droggen/BlueSense4/img/bot.png

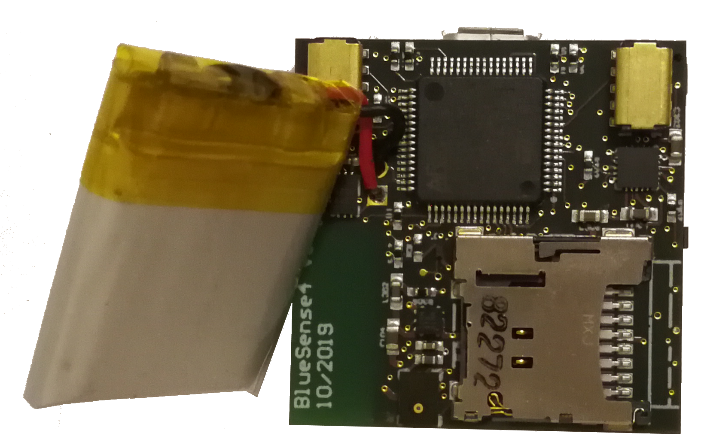
img/bot.png
