droggen/BlueSense4/img/side.png

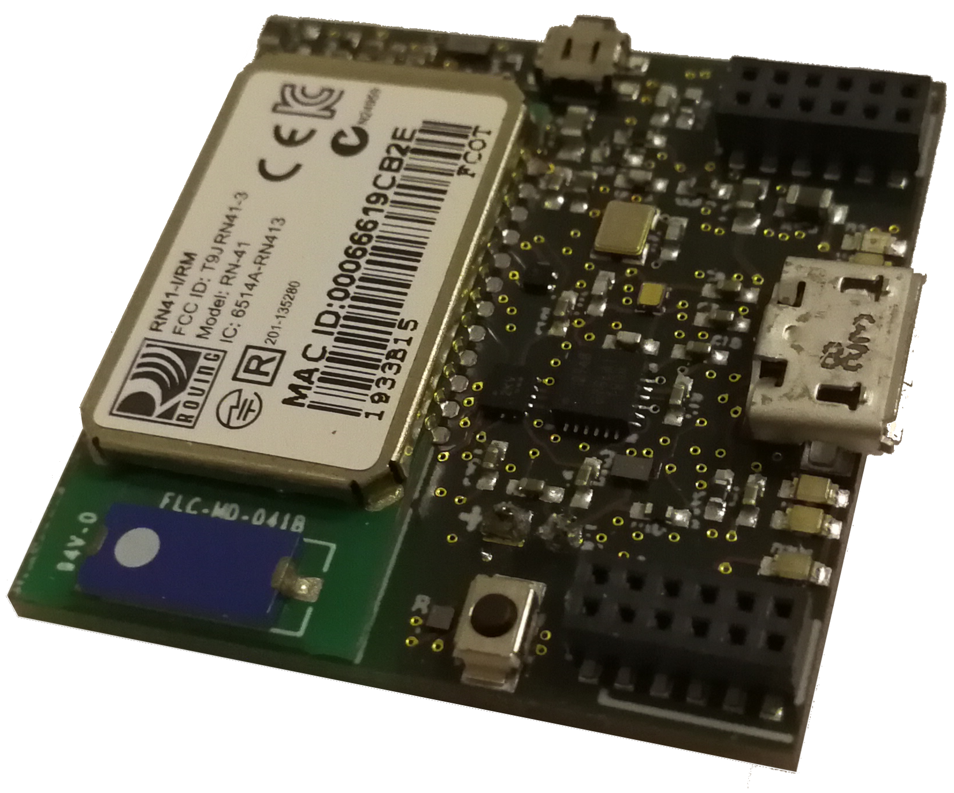
img/side.png
