droggen/BlueSense4/img/top.png

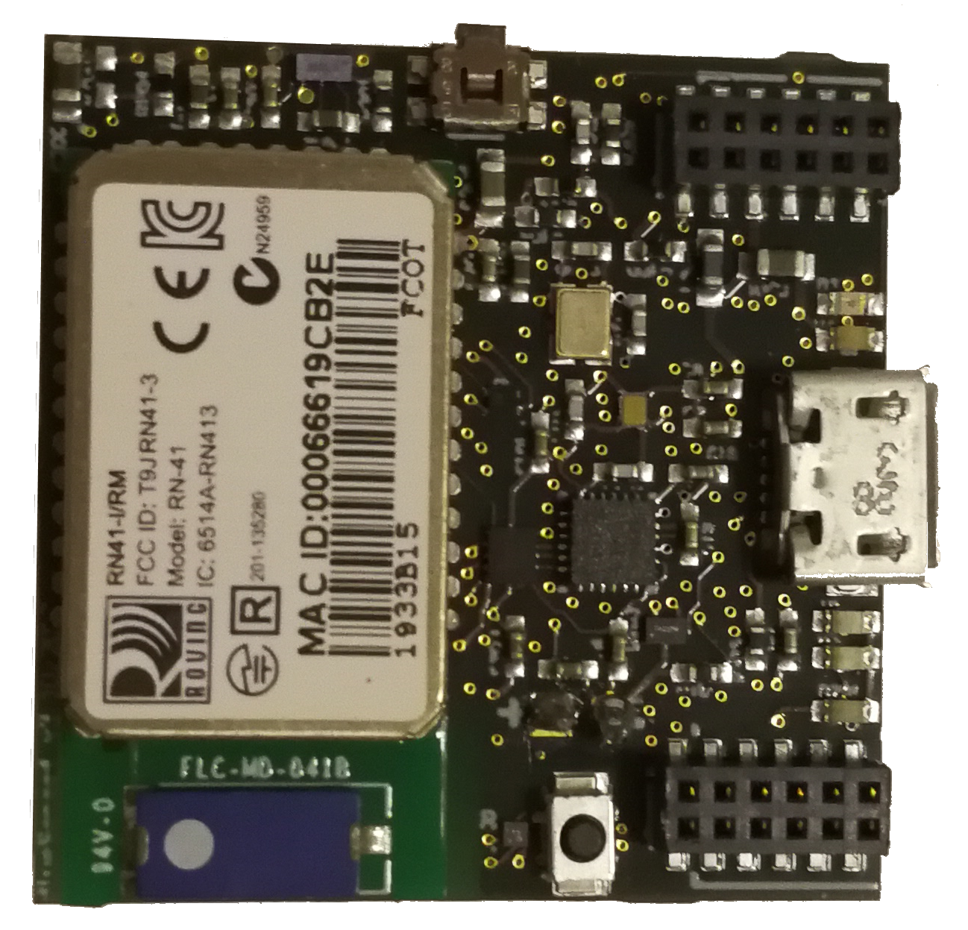
img/top.png
