droggen/BlueSense4/hardware/v4/bluesense4_v4.xls

Sheet: BOM Report
BOM Beta LAYOUT GmbH
 |  |  | <Parameter Title not found>
Source Data From: |  | bluesense4.PrjPcb
Project: |  | bluesense4.PrjPcb
Variant: |  | None
Creation Date: | 10.06.2020 |  |  | Total components (including those not to populate): |  |  |  | 92
Print Date: | 2020-06-10 | 16:18:03 |  | Total components to assemble: |  |  |  | 88
 |  |  |  | Total unique components (BoM lines): |  |  |  | 44
Production Quantity: | 1
Designator | Comment | LibRef | Footprint | Description | Quantity | Place YES / NO | Provided by Customer YES / NO | Distributor | Ordernumber | Remarks Customer | Remarks Beta
BT1 | Battery 3.7V Li-Ion | Battery | BAT-3LL | Multicell Battery | 1 | NO |  | Farnell | 2077885
C2, C5, C6, C8, C15, C16, C19, C101, C106, C202, C203, C204, C205, C207, C302, C307 | 100nF | Cap | 1005[0402] | CPU decoupling, CPU decoupling, CPU decoupling, CPU VDDA decoupling, Motion analog decoupling, Motion digital decoupling, Motion regout decoupling, CPU decoupling, uSD decoupling, Mic decoupling, Motion analog decoupling, BLE decoupling, RTC decoupling, Mic decoupling, CPU VDDA decoupling, Multivibrator decoupling | 16 | YES | NO | Farnell | 9402047
C3, C200, C201, C206, C308 | 4.7uF | Cap | 1005[0402] | SD decoupling, Bluetooth decoupling, Mic decoupling, Mic decoupling, Multivibrator time constant | 5 | YES | NO | Farnell | 2346876
C100, C102 | 13pF (id. 14pF) | Cap | 1005[0402] | CPU main clock | 2 | YES | NO | Farnell | 1758944
C104, C300, C301 | 22uF | Cap | 1608[0603] | uSD decoupling, VCC decoupling, AVCC decoupling | 3 | YES | NO | Digikey | 445-9077-1-ND
C105, C107 | 2pF | Cap | 1005[0402] | CPU RTC clock | 2 | YES | NO | Farnell | 2781430
C303, C304, C306 | 10uF | Cap | 1608[0603] | VBUS decoupling, Vreg vout decoupling, Vreg buck decoupling | 3 | YES | NO | Farnell | 2309028
C305 | 12pF | Cap | 1005[0402] | Vreg buck | 1 | YES | NO | Farnell | 1758943
D1 | Red | LED_SMD | LED_ROHM0603 | Status LED | 1 | YES | NO | Farnell | 1685094
D3, D200 | Yellow | LED_SMD | LED_ROHM0603 | Status LED | 2 | YES | NO | Farnell | 2687489
D201 | Green | LED_SMD | LED_ROHM0603 | Status LED2 | 1 | YES | NO | Farnell | 2687486
D300 | Blue | LED_SMD | LED_ROHM0603 | Charging LED | 1 | YES | NO | Farnell | 1685096
J1 | Molex MICRO USB B | MicroUSB-HRS-ZX62-AB-5PA | MICROUSB-MOLEX-47346 | Molex MICRO USB B - 47346-0001 | 1 | YES | NO | Digikey | WM17141CT-ND
J300 | Pad | PAD1 | TP2 |  | 1 | NO
L300, L301, L302 | 4.7uH | Inductor | 1608[0603] | Buck, AVCC filter, Periph filter | 3 | YES | NO | Farnell | 2215636
P2, P5 | Header 12H | Header 12H | Samtec CLP-106 | Header, 12-Pin, Right Angle | 2 | YES | NO | Samtec | CLP-106-02-L-D-P
P300, P301 | Samtec CLP-105-02-L-D | Header 10H | Samtec CLP-105b | Expansion bot, Expansion bottom | 2 | YES | NO | Samtec | CLP-105-02-L-D-P
Q300 | MOSFET-N | MOSFET-N | SOT883 | N-Channel MOSFET | 1 | YES | NO | Farnell | 2498592
R100, R200 | 0R | Res Semi | 1005[0402] | STM bootloader bridge, Bluetooth factory reset pad | 2 | NO |  | Farnell | 2059190
R313, R314 | 0R | Res Semi | 1005[0402] | RTC_INT bridge, PWR_ON bridge | 2 | YES | NO | Farnell | 2059190
R102, R204, R311 | 47k | Res Semi | 1005[0402] | Boot1 pullup, Bluetooth factory reset pad, Boot1 pullup | 3 | YES | NO | Farnell | 1469719
R201, R202, R312, RD1, RD3, RD200, RD201, RD300 | 4k7 | Res Semi | 1005[0402] | I2C pullup, I2C pullup, PWR_ON pull down, LED, LED, LED, LED, LED | 8 | YES | NO | Farnell | 1738858
R300, R309 | 0R22 | Res Semi | 1005[0402] | AVCC filter, Periph filter | 2 | YES | NO | Farnell | 1838595
R301, R304 | 536k | Res Semi | 1005[0402] | Multivibrator time constant, LDO sense | 2 | YES | NO | Farnell | 2302922
R302, R305 | 1M5 | Res Semi | 1005[0402] | LDO sense, Buck sense | 2 | YES | NO | Farnell | 2447129
R303 | 820 | Res Semi | 1005[0402] | VUSB divider | 1 | YES | NO | Farnell | 2447218
R306 | 470k | Res Semi | 1005[0402] | Buck sense | 1 | YES | NO | Farnell | 2141002
R307 | 7k5 | Res Semi | 1005[0402] | Charge current | 1 | YES | NO | Farnell | 2073238
R308 | 100R | Res Semi | 1005[0402] | Bleed resistor | 1 | YES | NO | Farnell | 2302528
R310 | 1.2k | Res Semi | 1005[0402] | VUSB divider | 1 | YES | NO | Farnell | 2447122
S4 | B3U-3000P | SW-PB | EVQP7A/J | Switch | 1 | YES | NO | Digikey | P16763CT-ND
U3 | ICM-20948 | MPU9250 | QFN40P300X300X105_HS-25L | Invensense ICM-20948 (ex MPU9250) | 1 | YES | NO | Digikey | 1428-1123-1-ND
U8 | LTC3553 | LTC3553 | LTC3553 | Linear LTC3553 | 1 | YES | NO | Digikey | LTC3553EUD#PBF-ND
U101 | RN41-I/RM | RN41 | rn41 | RN41 | 1 | YES | NO | Digikey | 740-1007-ND
U102 | STM32L496RET | STM32L496RET | STM-LQFP64_V | ARM Cortex-M4 32-bit MCU+FPU, 105 DMIPS, 256 kB Flash, 64 kB Internal RAM, 48 I/Os, 64-pin LQFP, -40 to 85 degC, Tray | 1 | YES | NO | Digikey | 497-17172-ND
U103 | Molex uSD socket #503182 | Molex uSD socket #503182 | Molex uSD Socket #503182 (v2) |  | 1 | YES | NO | Mouser | 538-503182-1852
U200 | M24xxx | M24xxx | UltraThinWLCSP | I2C EEPROM (M24128S-FCUT) | 1 | YES | NO | Farnell | 2449210
U201, U201b | MP34DT05 | MP34DT05 | MP34DT06 |  | 2 | YES | NO | Farnell | 2980885
U202 | TXB0104_1 | TXB0104_1 | R-PUQFN-N12 | 4-Bit Bidirectional Voltage-level Translator With Automatic Direction Sensing | 1 | YES | NO | Digikey | 296-25888-1-ND
U203 | TXB0101 | TXB0101 | DSBGA6 | 1-Bit Bidirectional Voltage-level Translator With Automatic Direction Sensing | 1 | YES | NO | Digikey | 296-21927-1-ND
U204 | MAX31343 RTC | DS31343 | 8-WLP | MAX31343 RTC | 1 | YES | NO | Digikey | 175-MAX31343EKA+-ND
U300 | LTC2942 | LTC2942 | DFN-6 | Coulomb counter | 1 | YES | NO | Digikey | LTC2942CDCB-1#TRMPBFCT-ND
U301 | TPS22810 | TPS22810-WSON | TPS22810-WSON | 79-mΩ On-Resistance Load Switch With Thermal Protection | 1 | YES | NO | Digikey | 296-47868-1-ND
U302 | SN74LVC1G123YZP | SN74LVC1G123 |  | Multivibrator | 1 | YES | NO | Digikey | 296-21058-1-ND
U303 | TLV713 | TLV713 | TI-DQN4-480X480TP_V_dan |  | 1 | YES | NO | Digikey | 296-40652-1-ND
Y100 | Quartz4pin | Quartz4pin | Abracon Crystal 2.0x1.6mm | ABM11-16.000MHZ-12-N1G-T | 1 | YES | NO | Farnell | 3228464
Y101 | Quartz4pin | Quartz4pin | ABRACON CRYSTAL 1.2x1 | ABS04W-32.768KHZ-6-D2-T5 (6pF) | 1 | YES | NO | Digikey | 535-14814-1-ND

Sheet: Project Information
Project Full Path | Free Documents
Project Filename | Free Documents
Variant Name | None
Data-Source Filename | BS50602e3f4ab07_UniAdc_pcbpool_20120924115706.PcbDoc
Data-Source Full Path | U:\Job\BA\Altium Testfile\BS50602e3f4ab07_UniAdc_pcbpool_20120924115706.PcbDoc
Title | Bill of Materials For PCB Document [BS50602e3f4ab07_UniAdc_pcbpool_20120924115706.PcbDoc]
Total Quantity | 55
Report Time | 10:07:24
Report Date | 16.10.2012
Report Date & Tine | 16.10.2012 10:07:24
Output Name | Bill of Materials
Output Type | BOM_PartType
Output Generator Name | ReportComponents
Output Generator Description | Component Reports
