droggen/BlueSense4/hardware/v4/bluesense_v4_schematic.pdf

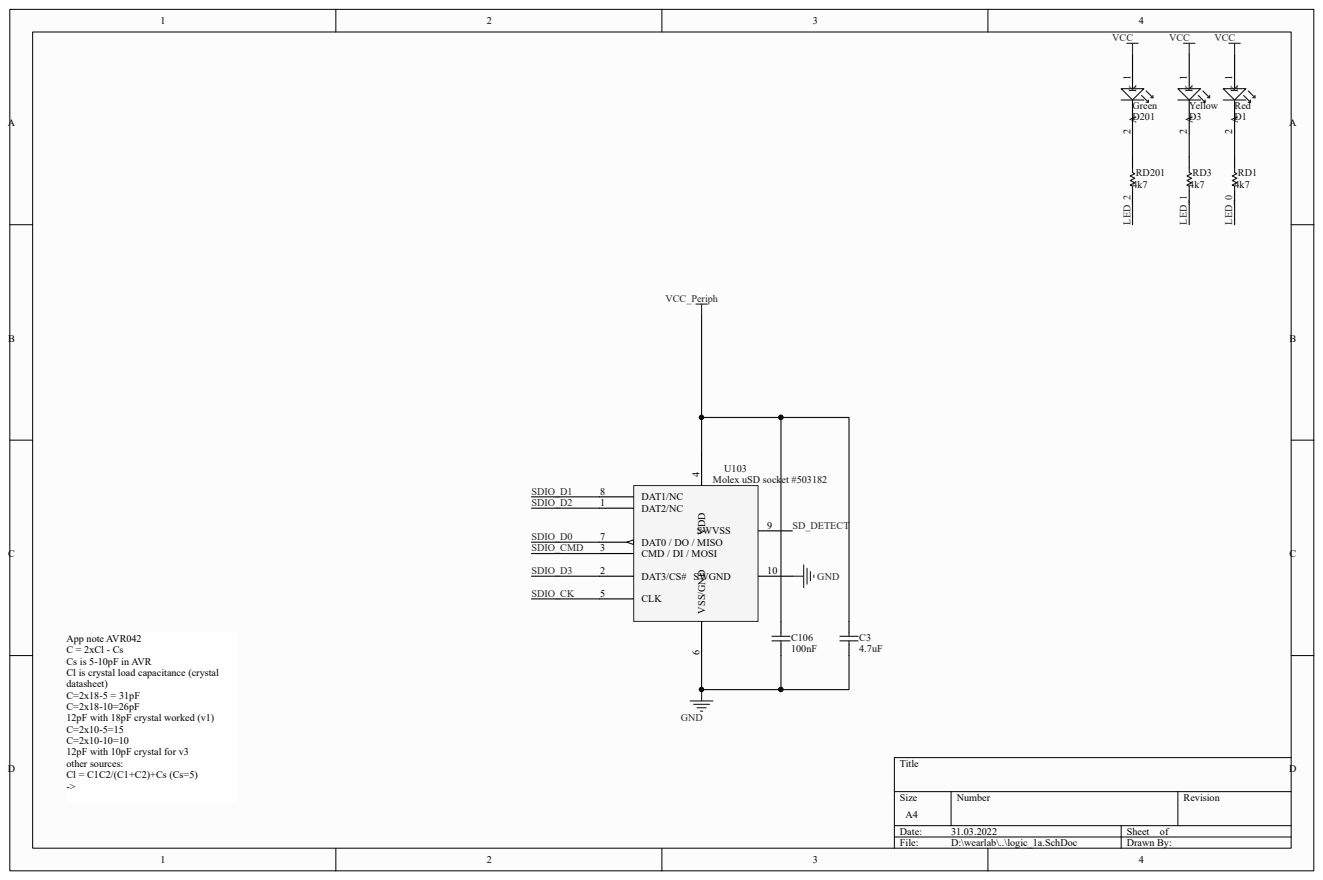
[picture p5: page 1]
Title; Size; Number; Revision; Date:; Sheet of; File:; D:\wearlab\..\logic_1a.SchDoc; Drawn By:; VCC_Periph; GND; VCC; Yellow; Red; DAT0 / DO / MISO 7; DAT2/NC 1; DAT3/CS# 2; CMD / DI / MOSI 3; VDD; CLK 5; VSS/GND; DAT1/NC 8; SWVSS; SWGND; LED_2; Green; SDIO_D0; SDIO_D1 SDIO_D2; SDIO_D3; SDIO_CK; SDIO_CMD; LED_1; LED_0; SD_DETECT

Molex uSD socket #503182

App note AVR042
C = 2xCl - Cs
Cs is 5-10pF in AVR
Cl is crystal load capacitance (crystal
datasheet)
12pF with 18pF crystal worked (v1)
12pF with 10pF crystal for v3
other sources:

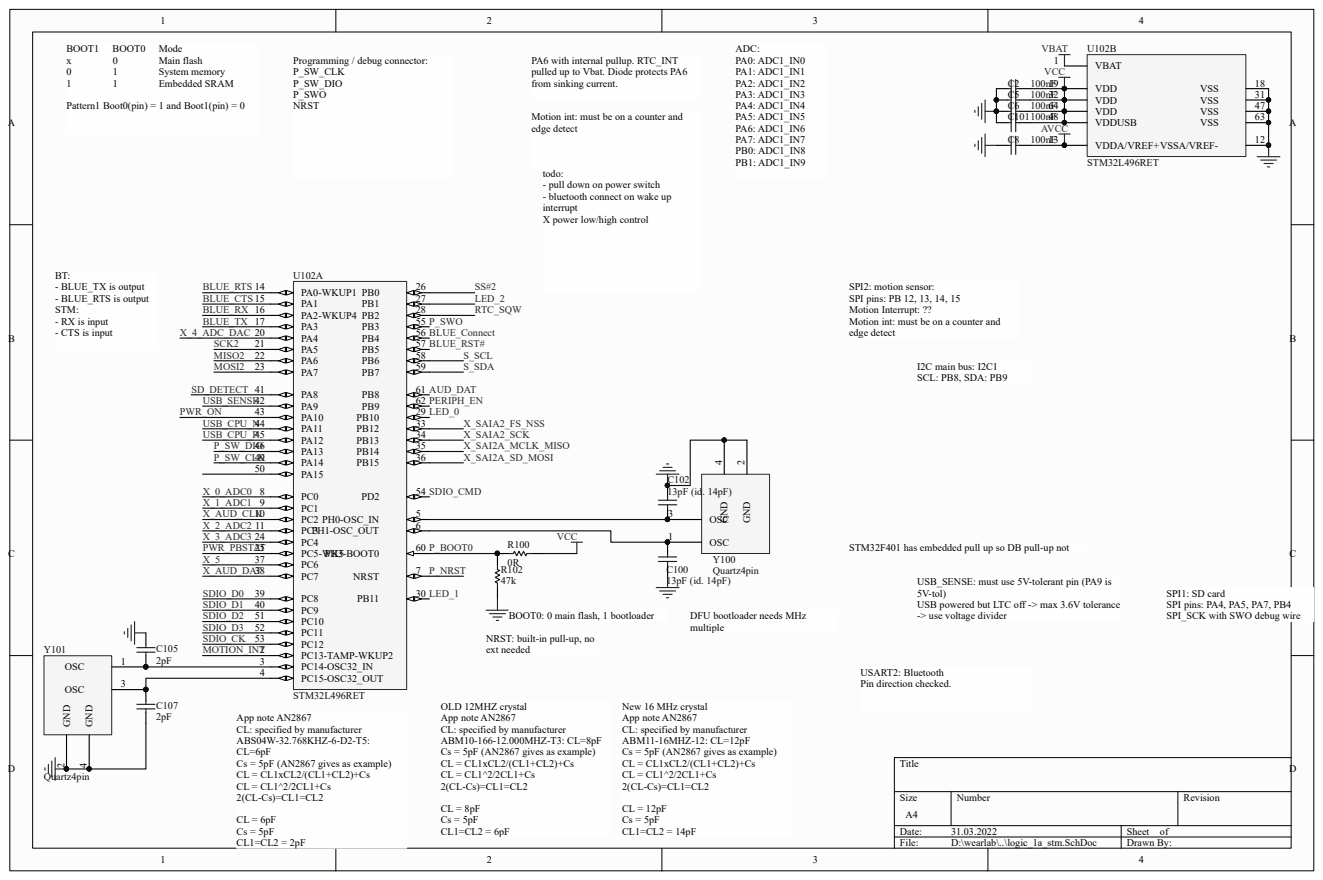
[picture p6: page 2]

PA6 with internal pullup. RTC_INT
pulled up to Vbat. Diode protects PA6
from sinking current.

Motion int: must be on a counter and
edge detect

todo:
- pull down on power switch
- bluetooth connect on wake up
interrupt
X power low/high control

SPI2: motion sensor:
SPI pins: PB 12, 13, 14, 15
Motion Interrupt: ??

STM32F401 has embedded pull up so DB pull-up not

USB_SENSE: must use 5V-tolerant pin (PA9 is
5V-tol)
USB powered but LTC off -> max 3.6V tolerance
-> use voltage divider

SPI1: SD card
SPI pins: PA4, PA5, PA7, PB4
SPI_SCK with SWO debug wire

DFU bootloader needs MHz
multiple

NRST: built-in pull-up, no
ext needed

OLD 12MHZ crystal
App note AN2867
CL: specified by manufacturer
ABM10-166-12.000MHZ-T3: CL=8pF
Cs = 5pF (AN2867 gives as example)
CL = CL1xCL2/(CL1+CL2)+Cs

New 16 MHz crystal
ABM11-16MHZ-12: CL=12pF

ABS04W-32.768KHZ-6-D2-T5:

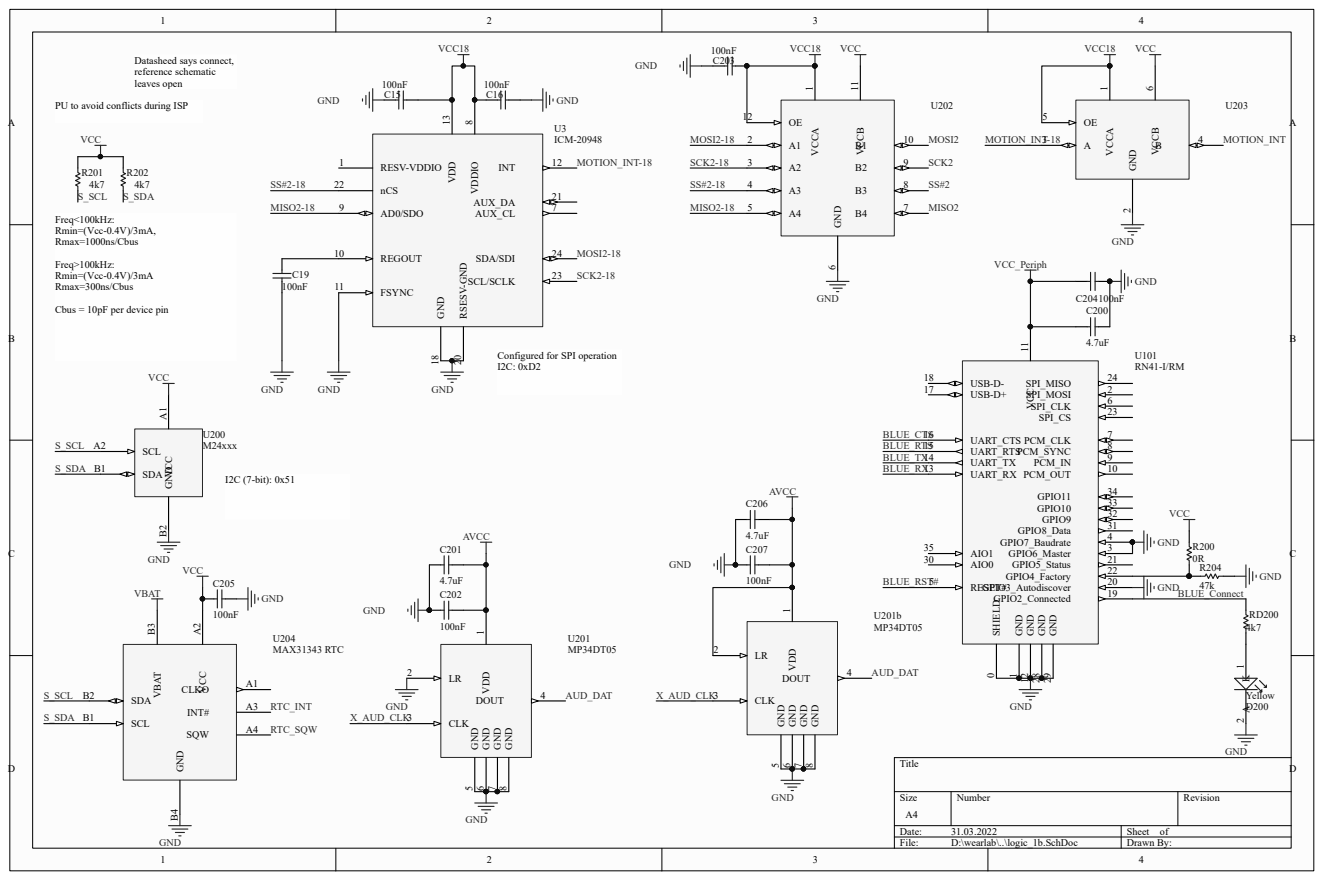
[picture p7: page 3]

PU to avoid conflicts during ISP

Cbus = 10pF per device pin

4.7uF VDD
Configured for SPI operation

1 GND 12 GND 29 GND 28 VCC 11

I2C (7-bit): 0x51 GND B² VCC A¹

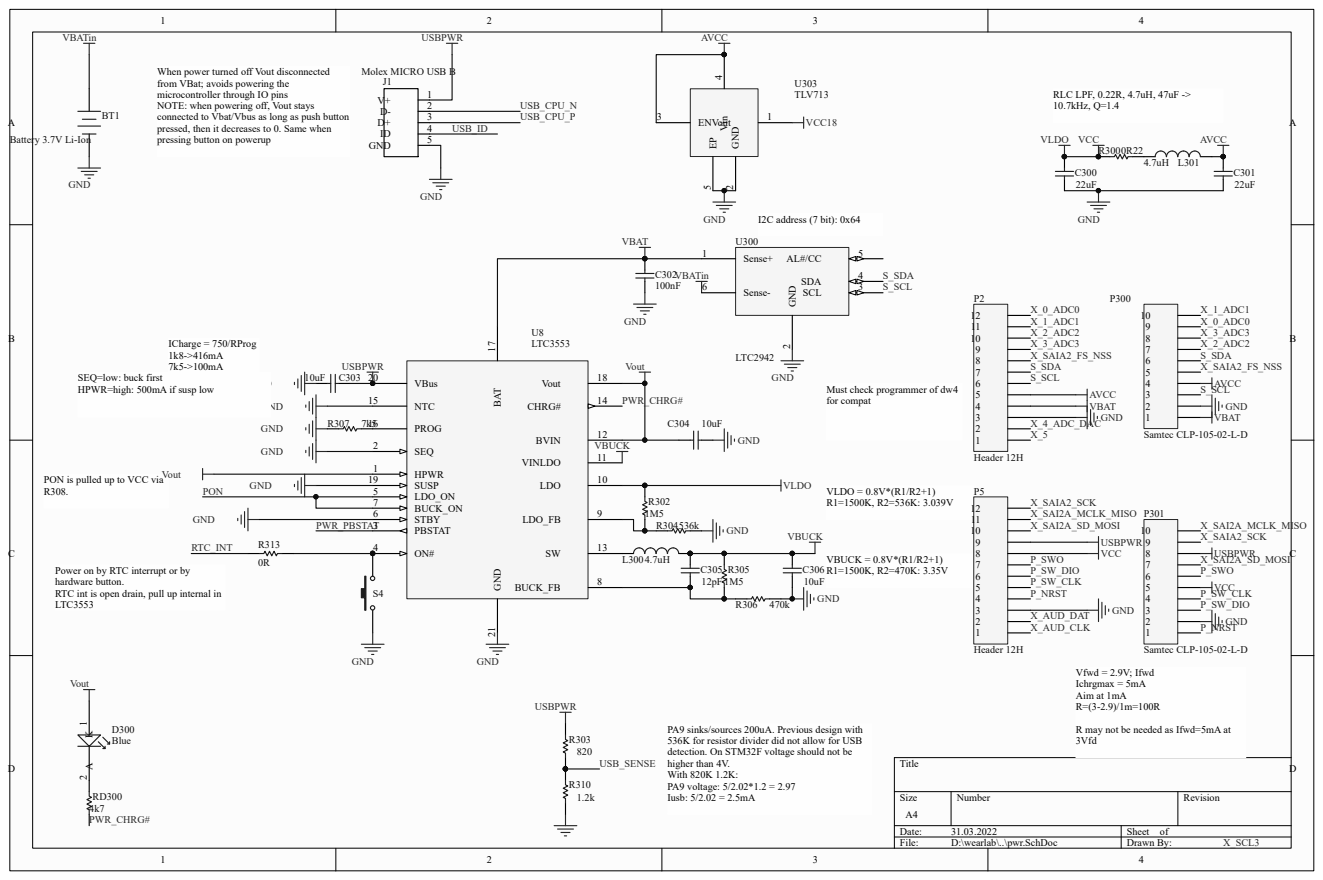
[picture p8: page 4]

When power turned off Vout disconnected
from VBat; avoids powering the
microcontroller through IO pins
NOTE: when powering off, Vout stays
connected to Vbat/Vbus as long as push button
pressed, then it decreases to 0. Same when
pressing button on powerup

SEQ=low: buck first
HPWR=high: 500mA if susp low

Must check programmer of dw4
for compat

PON is pulled up to VCC via

Power on by RTC interrupt or by
hardware button.
RTC int is open drain, pull up internal in
LTC3553

PA9 sinks/sources 200uA. Previous design with
536K for resistor divider did not allow for USB
detection. On STM32F voltage should not be
higher than 4V.
With 820K 1.2K:
PA9 voltage: 5/2.02*1.2 = 2.97
Iusb: 5/2.02 = 2.5mA

R may not be needed as Ifwd=5mA at
3Vfd

C C

B B

A A

== Power circuit ==
There are 4 cases:
A. Power is off, pwron through extpwr or PB
B. Power is off, pwron through RTC interrupt
C. Power is on, pwroff through CPU (pull up/down pwron)
D. Power is on, pwroff through hrst (long-press pb)

ON semi NSR05F40NXT5G has
Vf=0.1V 75C
Vf=0.2V 25C
Vf=0.3V -25C

Input voltage range: 3.4-4.3 Output voltage range: 2.5-4.0V

Has to operate with Vbat: 3.4V-4.3V

Put NMOS transistor to discharge NXP PMZ200UNE

== Falling edge detector on PWR_ON==
This generates a positive puse on the falling edge of PWR_ON (CPU controlled) or when VCC drops (e.g. through HRST). PWR_ON is a uC digital out and is pulled up to keep the supply active when the CPU is unprogrammed, in reset, or undergoing programming. Consequently, if VCC falls due to other reasons (e.g. due to a long-press/HRST on the LTC3553) a pulse is also generated as either VCC drops or PWR_ON drops (generally both drop at the same time as the uC is VCC powered).
Tpulse = C*R*K with K=1
Tpulse = R*C
C=2.2uF, R=450K -> 1s
* C=4.7uF, R=536 -> 2.5s GND

## 4 VCC

8

A# 1

B

2

CLR# 3 | Q

5

Ce | 6
Re/Ce | 7

U302
SN74LVC1G123YZP

GND

VBAT

VBAT

C308
4.7uF

R301
536k

PoffPulse

C307

100nF

GND

PoffPulse high indicates the
power must be cut off. | D
| 1

G

### 2 S

3

Q300
MOSFET-N

== Bleeder circuit ==
P=U2/R=90mW

GND

R308
100R

VCC 1

1

J300

Power switch TPS22810

== Power circuit ==
A. Power is off, pwron through extpwr or PB
- LTC turns on for 5 seconds; PON pulled high via R308.
- If cpu unprogrammed/being programmed: PWR_ON HiZ; A# is VCC and no poffpulse.
- If cpu programmed: actively drives PWR_ON low.

PON

PWR_ON

R312
4k7

== Power circuit ==
B. Power is off, pwron through RTC interrupt
Same as A: rtc interrupt is equivalent to button press.

== Power circuit ==
C. Power is on, pwroff through CPU (pull up/down pwron)
- CPU toggles high->low PWR_ON. PoffPulse of 2.5 second generated.
- PON driven to ground for 2.5 seconds; LTC turns off for 1 sec at least.
- VCC should be close to zero with bleeder R308. LTC PON threshold is 1.2V, so VCC must drop below 1.2V during 1

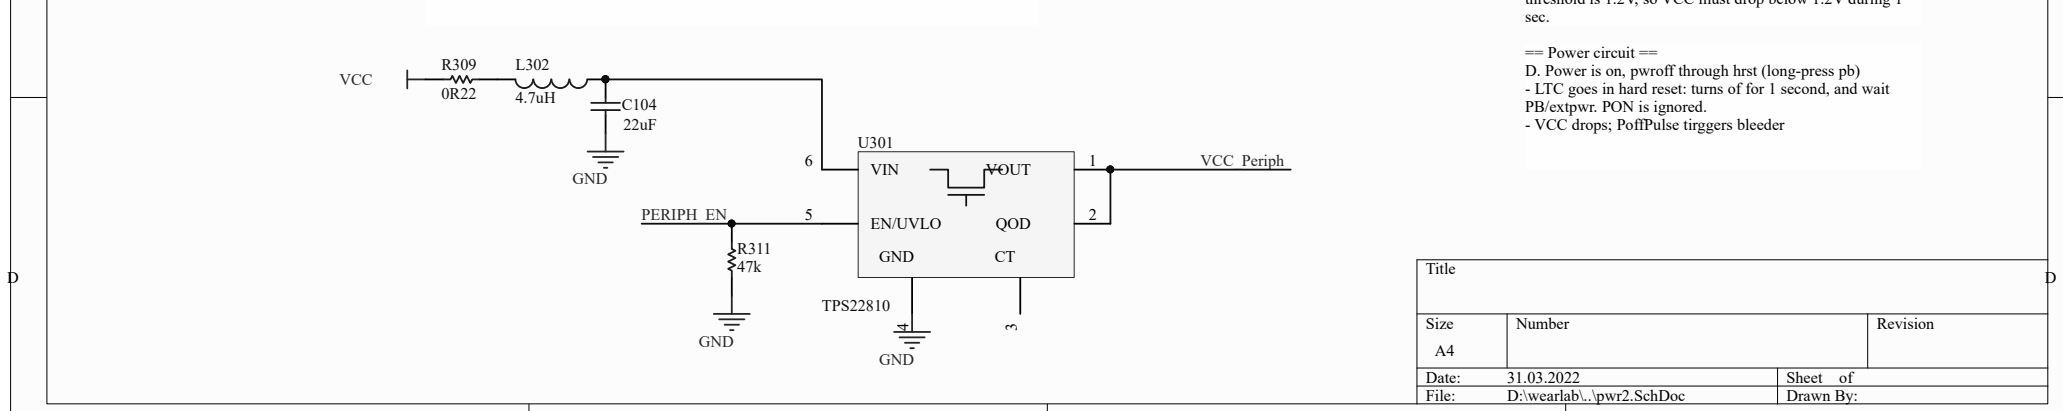
[picture p9: figure]
Title; Size; Number; Revision; File:; D:\wearlab\..\pwr2.SchDoc; Drawn By:; VIN 6; GND4; EN/UVLO 5; QOD; VOUT; TPS22810; GND; VCC_Periph; PERIPH_EN; VCC; sec.; == Power circuit ==; PB/extpwr. PON is ignored. - VCC drops; PoffPulse tirggers bleeder

D. Power is on, pwroff through hrst (long-press pb)
- LTC goes in hard reset: turns of for 1 second, and wait

VCC

R314
0R
