droggen/BlueSense4/hardware/v4/bluesense4_v4_layout.pdf

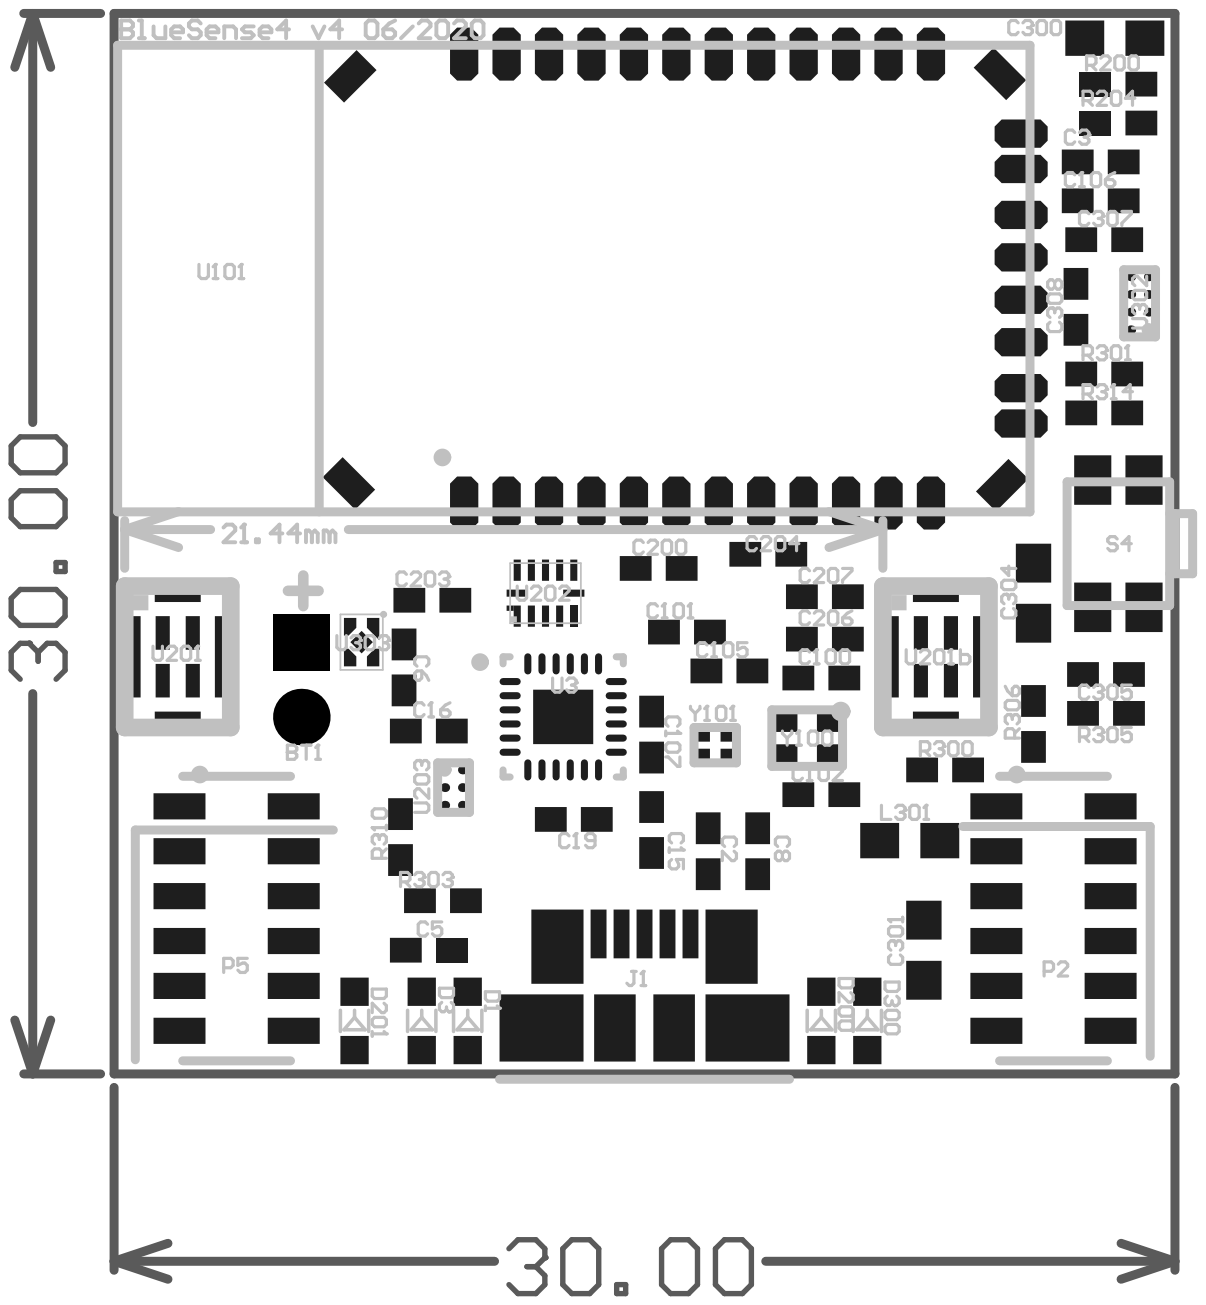
[picture p10: page 1]

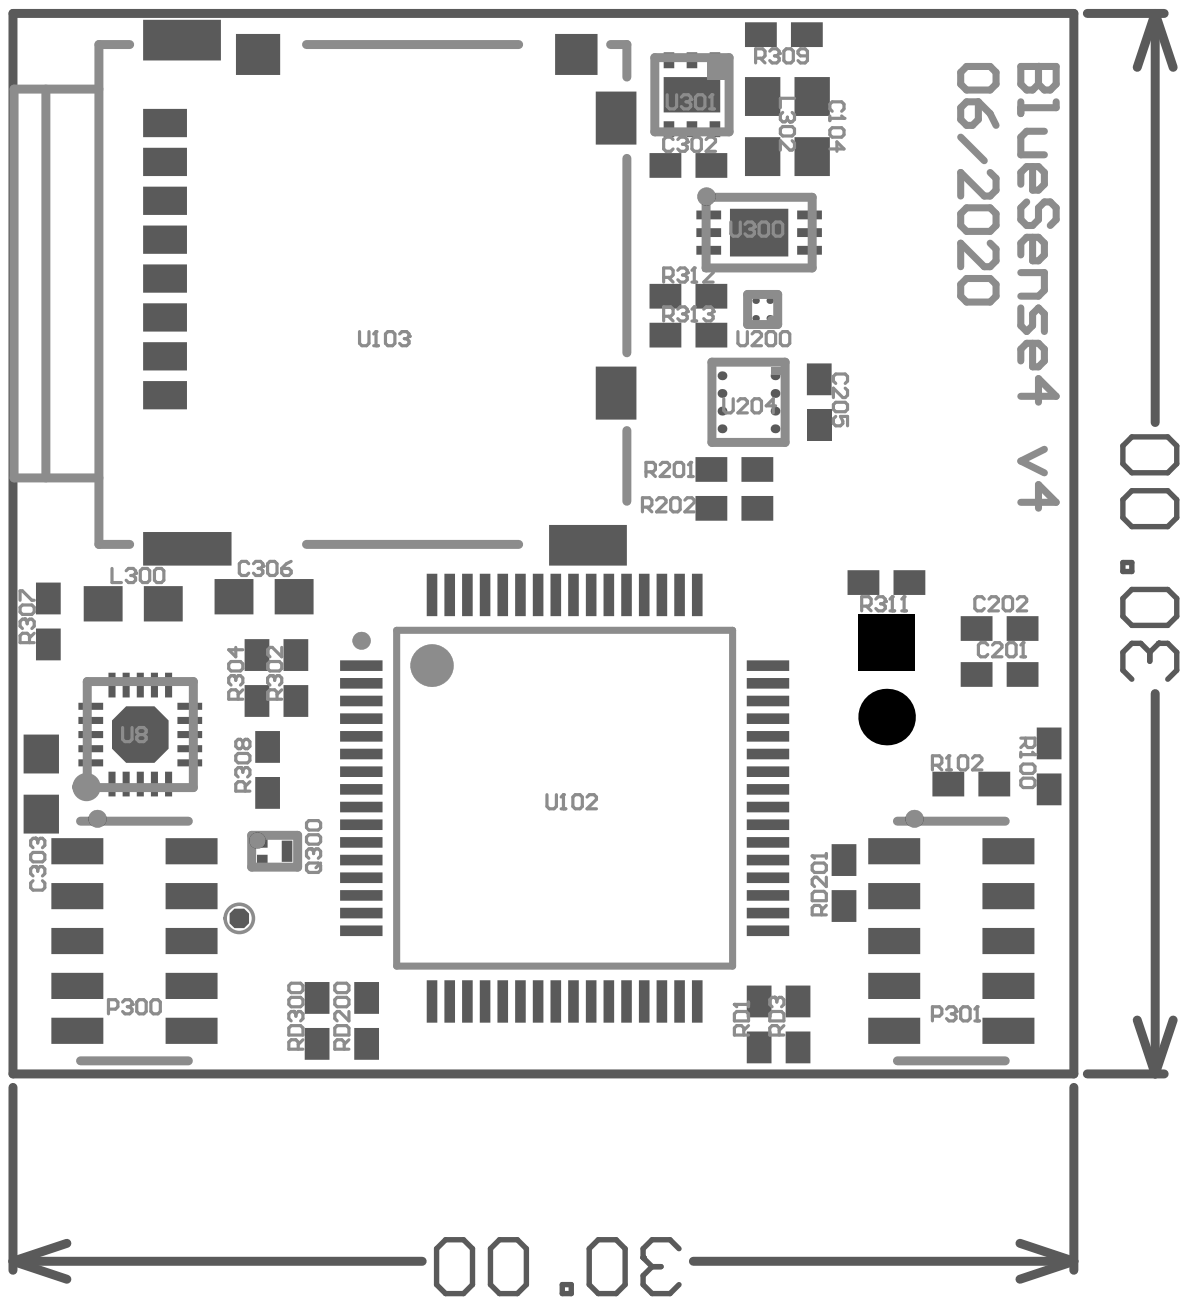
[picture p11: page 2]
