droggen/BlueSense4/hardware/v3/sch.pdf

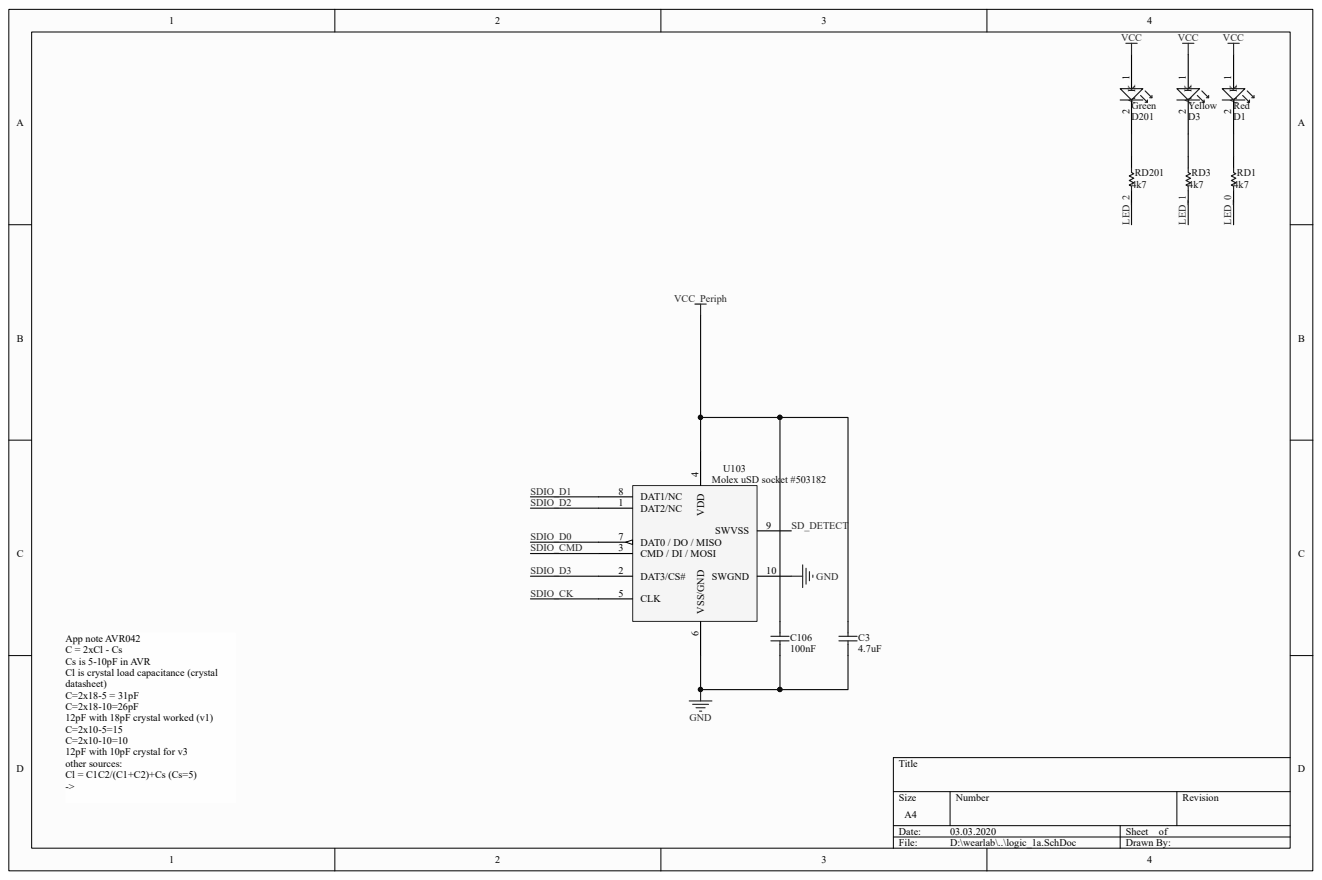
[picture p12: page 1]
Title; Size; Number; Revision; Date:; Sheet of; File:; D:\wearlab\..\logic_1a.SchDoc; Drawn By:; VCC_Periph; GND; VCC; Yellow A; Red; DAT0 / DO / MISO 7; DAT2/NC 1; DAT3/CS# 2; CMD / DI / MOSI 3; VDD; CLK 5; VSS/GND; DAT1/NC 8; SWVSS; SWGND; LED_2; Green; SDIO_D0; SDIO_D1 SDIO_D2; SDIO_D3; SDIO_CK; SDIO_CMD; LED_1; LED_0; SD_DETECT

Molex uSD socket #503182

App note AVR042
C = 2xCl - Cs
Cs is 5-10pF in AVR
Cl is crystal load capacitance (crystal
datasheet)
12pF with 18pF crystal worked (v1)
12pF with 10pF crystal for v3
other sources:

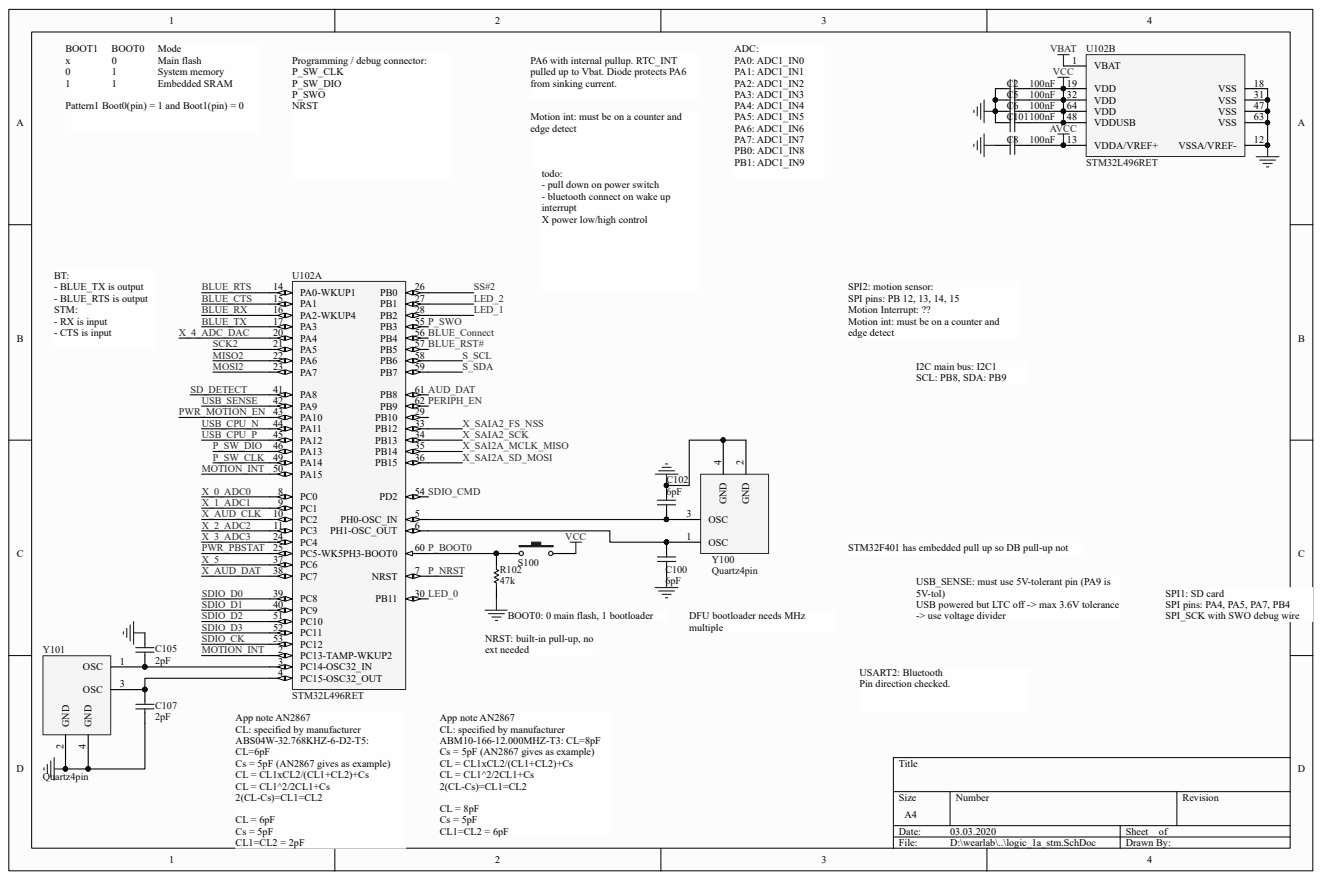
[picture p13: page 2]

PA6 with internal pullup. RTC_INT
pulled up to Vbat. Diode protects PA6
from sinking current.

Motion int: must be on a counter and
edge detect

todo:
- pull down on power switch
- bluetooth connect on wake up
interrupt
X power low/high control

SPI2: motion sensor:
SPI pins: PB 12, 13, 14, 15
Motion Interrupt: ??

STM32F401 has embedded pull up so DB pull-up not

USB_SENSE: must use 5V-tolerant pin (PA9 is
5V-tol)
USB powered but LTC off -> max 3.6V tolerance
-> use voltage divider

SPI1: SD card
SPI pins: PA4, PA5, PA7, PB4
SPI_SCK with SWO debug wire

DFU bootloader needs MHz
multiple

NRST: built-in pull-up, no
ext needed

App note AN2867
CL: specified by manufacturer
ABS04W-32.768KHZ-6-D2-T5:
Cs = 5pF (AN2867 gives as example)
CL = CL1xCL2/(CL1+CL2)+Cs

ABM10-166-12.000MHZ-T3: CL=8pF

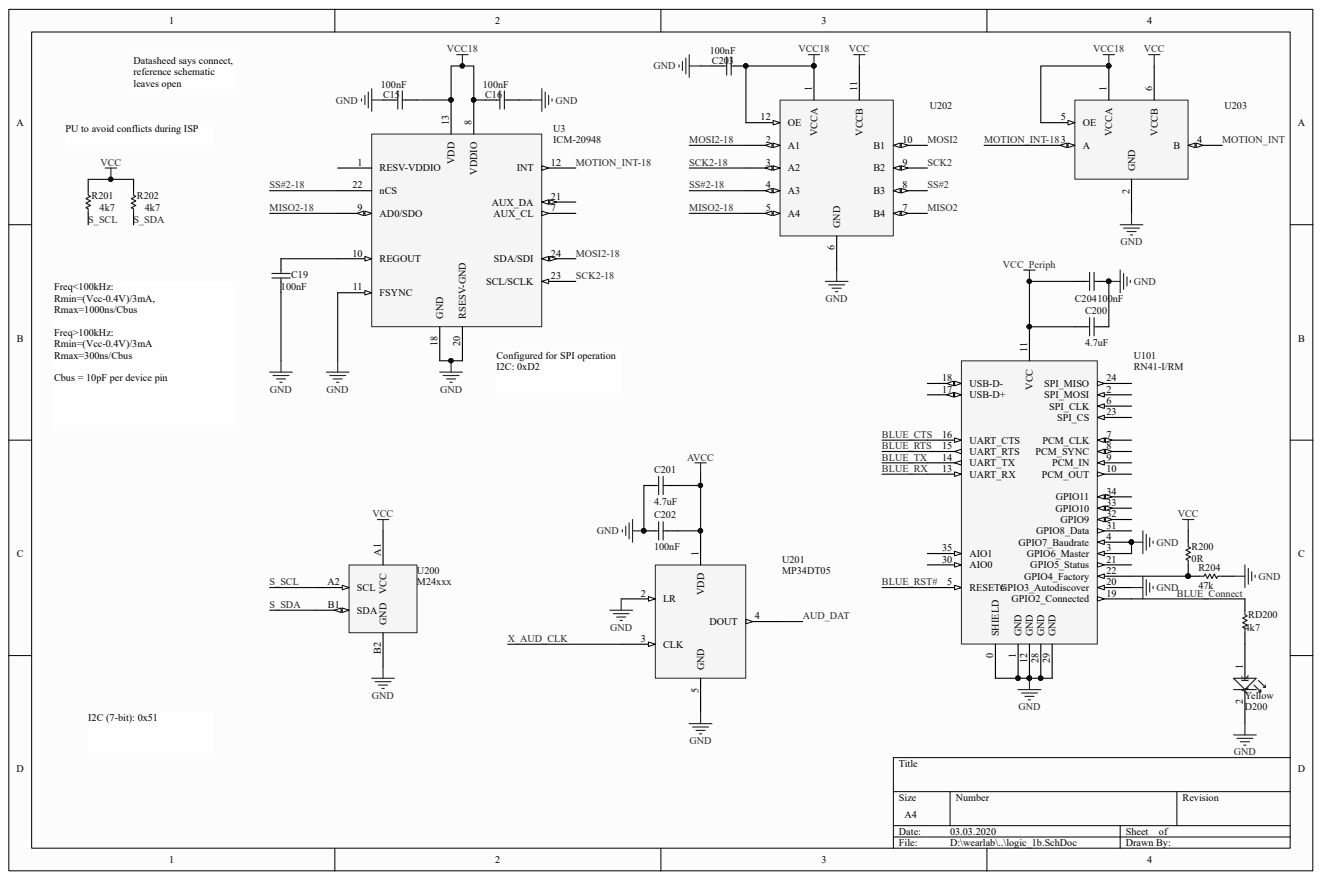
[picture p14: page 3]

PU to avoid conflicts during ISP

1 GND 12 GND 29 GND 28 VCC 11

Configured for SPI operation

Cbus = 10pF per device pin

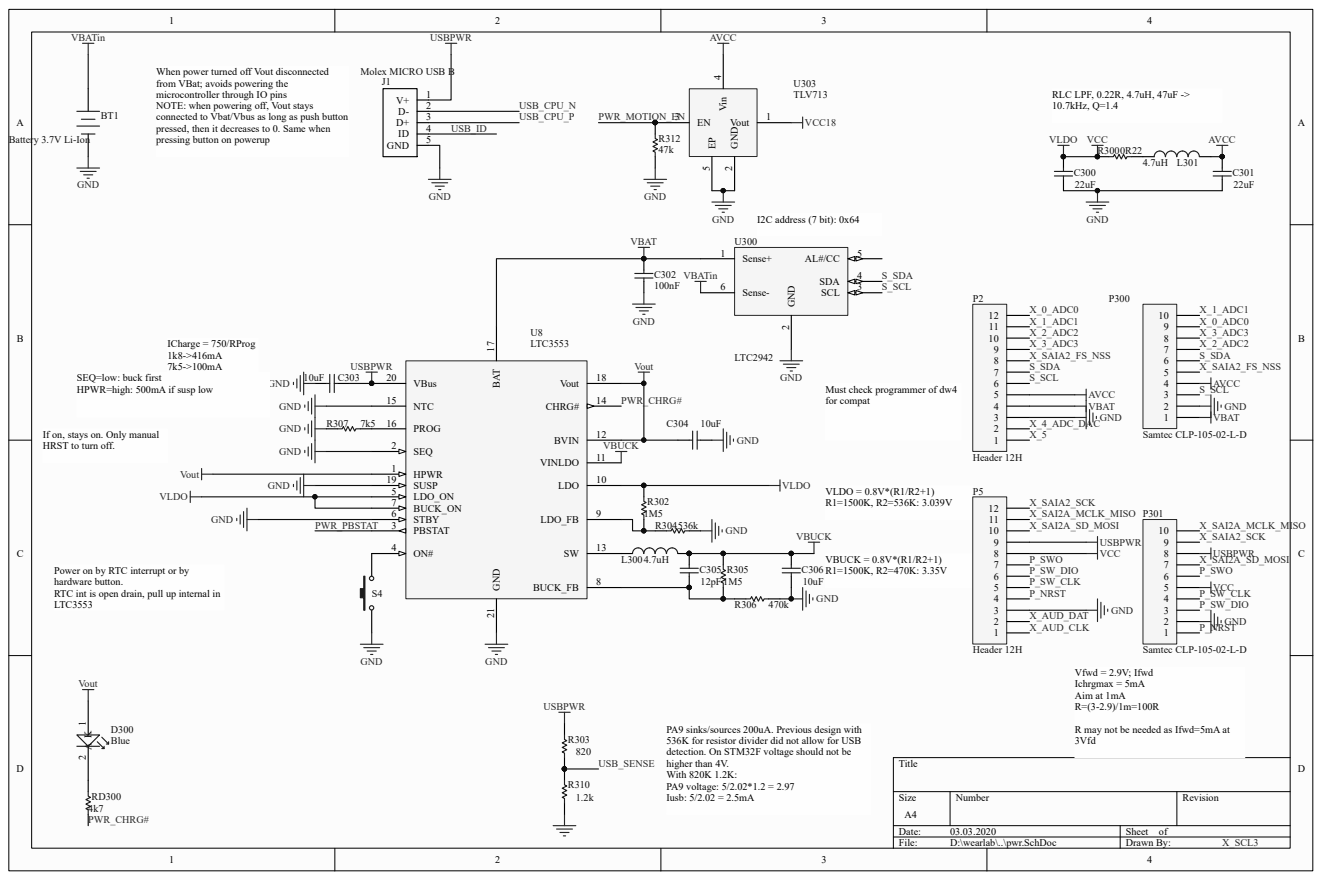
[picture p15: page 4]

When power turned off Vout disconnected
from VBat; avoids powering the
microcontroller through IO pins
NOTE: when powering off, Vout stays
connected to Vbat/Vbus as long as push button
pressed, then it decreases to 0. Same when
pressing button on powerup

SEQ=low: buck first
HPWR=high: 500mA if susp low

Must check programmer of dw4
for compat

If on, stays on. Only manual
HRST to turn off.

Power on by RTC interrupt or by
hardware button.
RTC int is open drain, pull up internal in
LTC3553

PA9 sinks/sources 200uA. Previous design with
536K for resistor divider did not allow for USB
detection. On STM32F voltage should not be
higher than 4V.
With 820K 1.2K:
PA9 voltage: 5/2.02*1.2 = 2.97
Iusb: 5/2.02 = 2.5mA

R may not be needed as Ifwd=5mA at
3Vfd

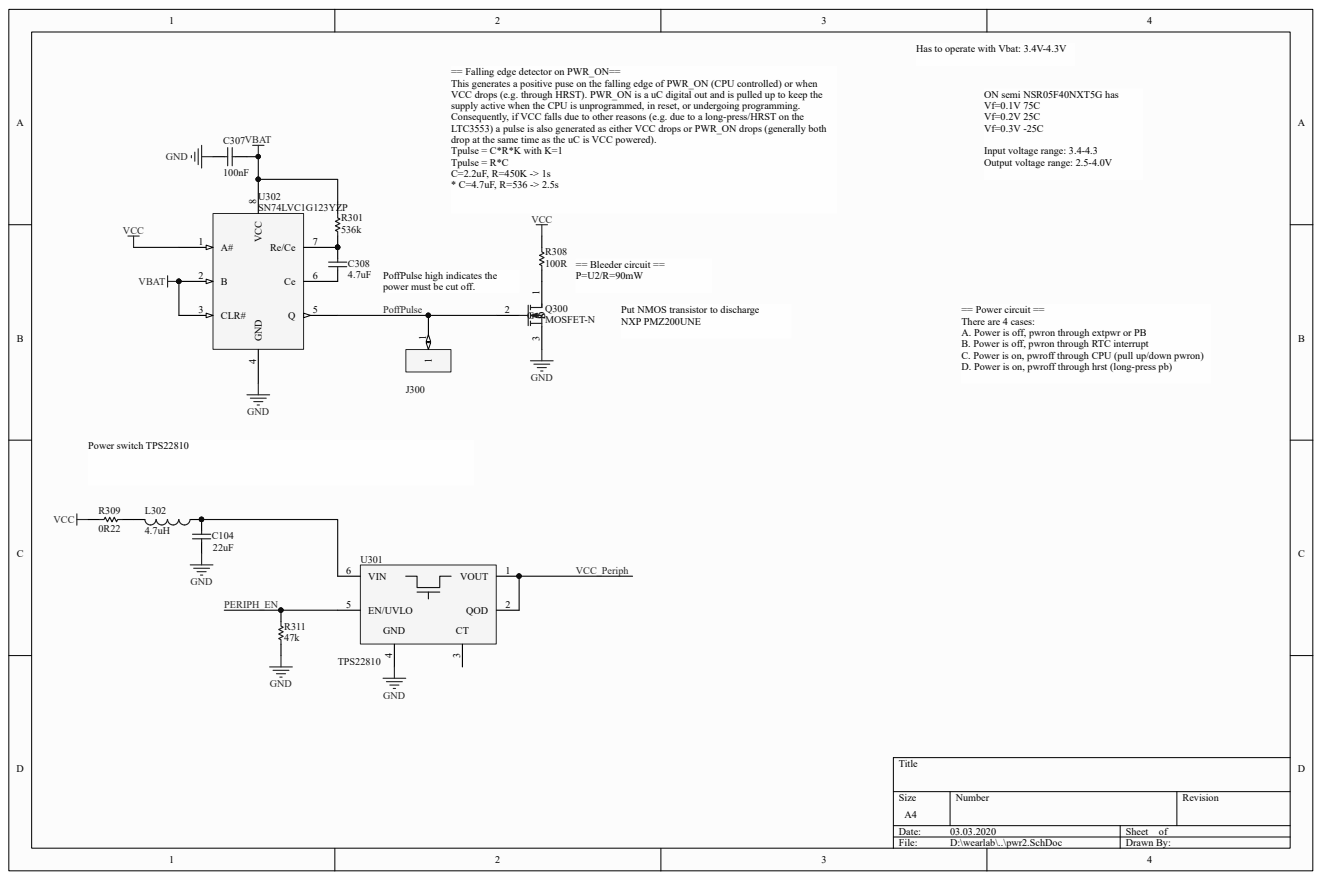
[picture p16: page 5]

Has to operate with Vbat: 3.4V-4.3V

== Falling edge detector on PWR_ON==
This generates a positive puse on the falling edge of PWR_ON (CPU controlled) or when
VCC drops (e.g. through HRST). PWR_ON is a uC digital out and is pulled up to keep the
supply active when the CPU is unprogrammed, in reset, or undergoing programming.
Consequently, if VCC falls due to other reasons (e.g. due to a long-press/HRST on the
LTC3553) a pulse is also generated as either VCC drops or PWR_ON drops (generally both
drop at the same time as the uC is VCC powered).
Tpulse = C*R*K with K=1
Tpulse = R*C

PoffPulse high indicates the

Put NMOS transistor to discharge
NXP PMZ200UNE

== Power circuit ==
There are 4 cases:
A. Power is off, pwron through extpwr or PB
B. Power is off, pwron through RTC interrupt
C. Power is on, pwroff through CPU (pull up/down pwron)
D. Power is on, pwroff through hrst (long-press pb)
