droggen/BlueSense4/hardware/v3/bluesense4_v3.pdf

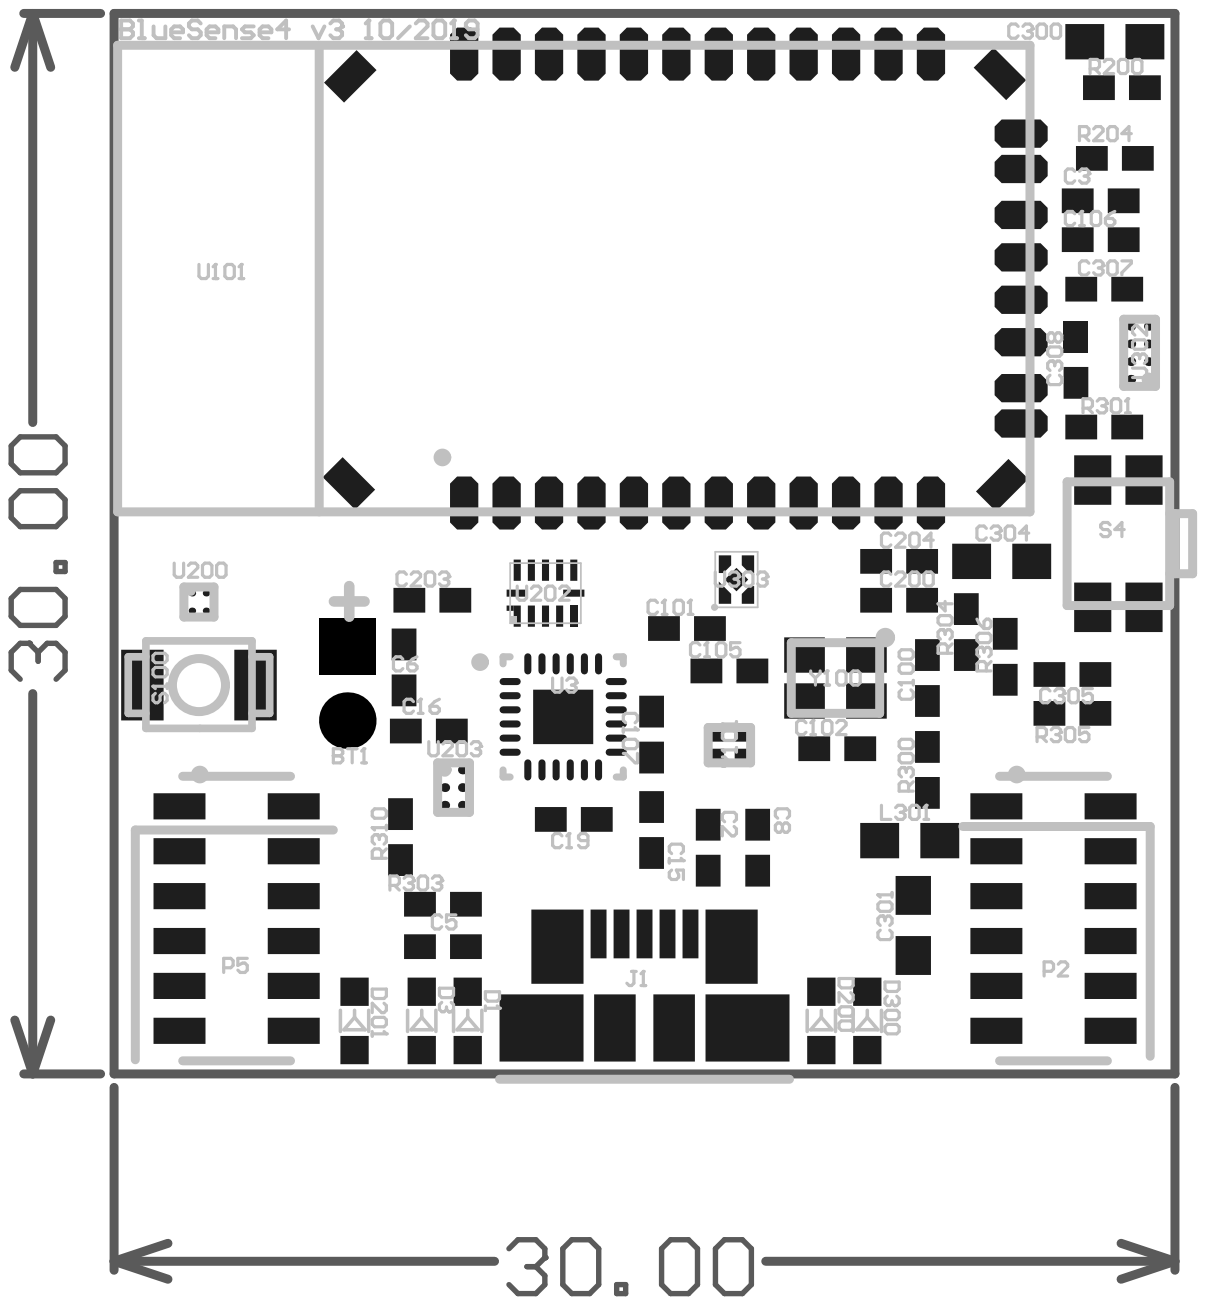
[picture p17: page 1]

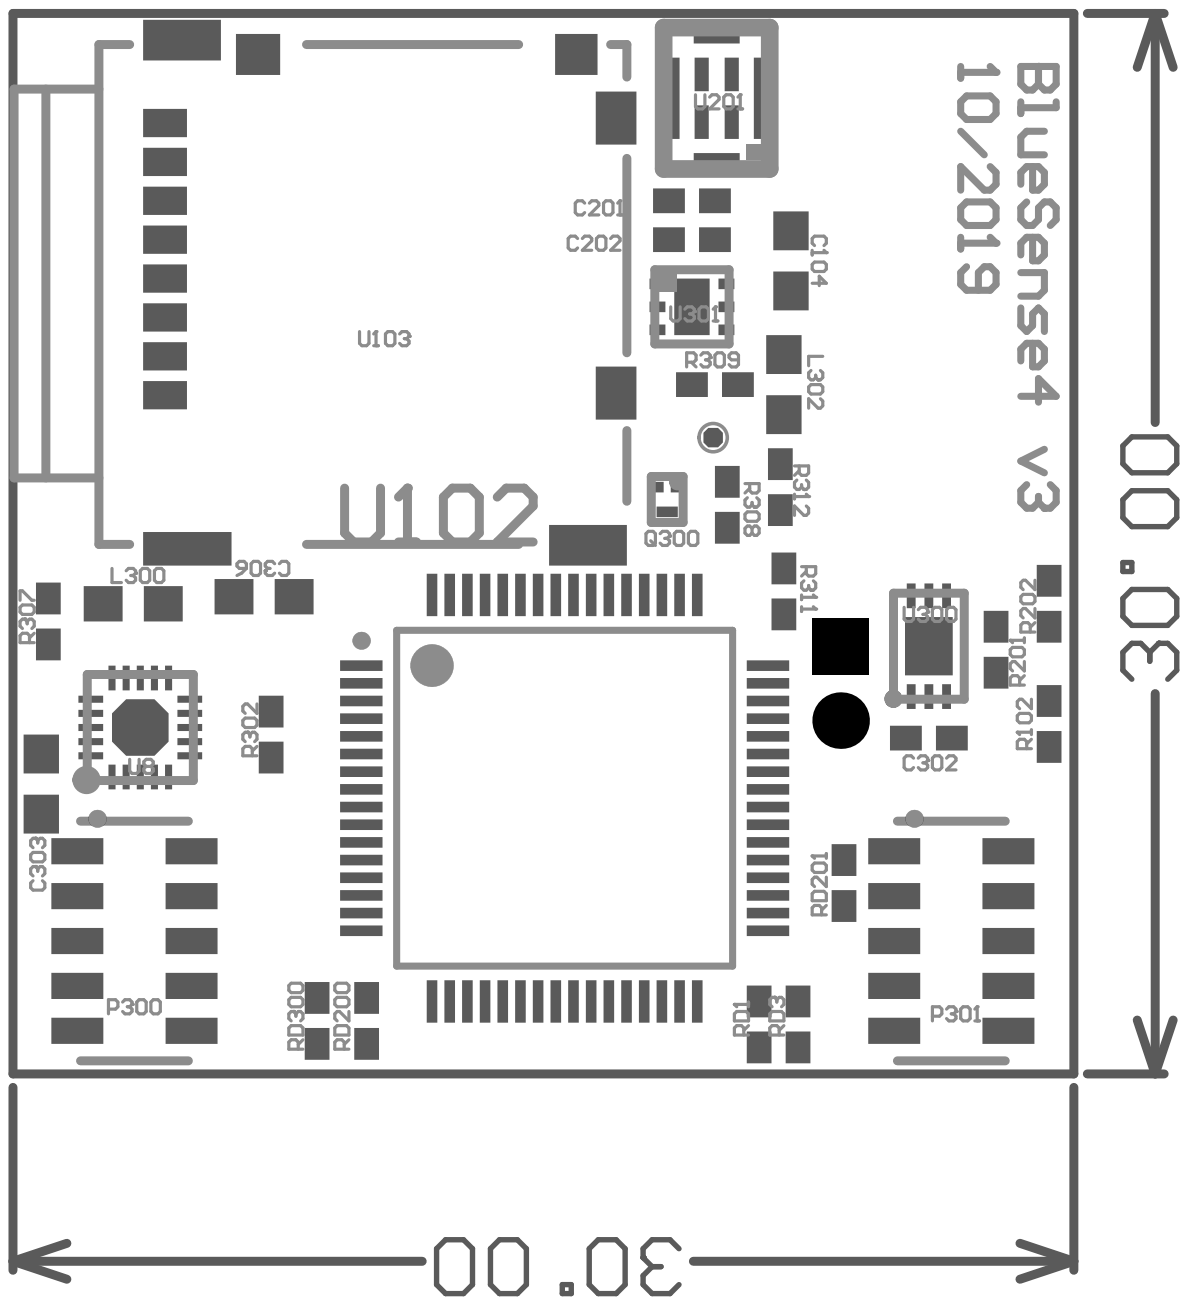
[picture p18: page 2]
