droggen/BlueSense4/firmware/v4/firmware-main/usrsrc/megalol/megalol_dsp_fsk.c

#include <stdio.h>
#include <malloc.h>
#include <string.h>
#include "stm32l496xx.h"
#include "megalol_dsp.h"
#include "megalol_dsp_r2iq.h"
#include "stmcic.h"
#include "global.h"
#include "dfsdm.h"
#include "megalol_comm_softuart.h"
#include "main.h"
#include "helper.h"
#include "ufat.h"
#include "wait.h"
#include "stmdac.h"
#include "megalol_dsp_fsk.h"
#include "stmadcfast.h"
#include "serial_usart3.h"
#include "stm32l4xx_hal.h"


#define DSP_FSK_USE_CIC_16BIT	1

// Allocate both 32-bit or 16-bit CIC result as tests/benchmarks use both
int _fsk_di[CICBUFSIZ/2+1],_fsk_dq[CICBUFSIZ/2+1];			// +1 to hold the previous sample value to ensure streaming implementation of crossproduct
short _fsk_dis[CICBUFSIZ/2+2],_fsk_dqs[CICBUFSIZ/2+2];		// +2: +1 to hold the previous sample value to ensure streaming implementation of crossproduct, and +1 for SIMD implementation reading 32-bit at a time.
short _fsk_tmp_di[CICBUFSIZ],_fsk_tmp_dq[CICBUFSIZ];		// Test variables: write two I, Q lanes prior to CIC filtering. Lanes have 0 I 0 -I ..., Q 0 -Q 0...
int _fsk_cp[CICBUFSIZ/2];									// Result of cross-product
int _fsk_cp2[CICBUFSIZ/2];
int _fsk_cp3[CICBUFSIZ/2];
unsigned char _fsk_binary[CICBUFSIZ/2+4];						// Binary outcome of demodulation, and input to decoding. Extra space for SIMD processing.
unsigned char _fsk_binary2[CICBUFSIZ/2+4];						// Binary outcome of demodulation, and input to decoding
unsigned char _fsk_binary3[CICBUFSIZ/2+4];						// Binary outcome of demodulation, and input to decoding
int _fsk_downsampling=2;

// Spectrum generated from Matlab with an asymetrial shape
short testsignal_recognizablespectrum[FSKTESTSIGNALLEN]={4095,1704,1378,2239,1989,1899,2250,1764,2233,1845,1866,1945,1792,1969,1768,1873,1985,1848,1883,1872,1846,1930,1747,1937,1912,1872,1937,1861,1999,1890,1856,1915,1911,1924,1868,1866,2004,1881,1880,1889,1883,1923,1797,1911,1915,1869,1880,1887,1948,1890,1808,1922,1927,1904,1872,1872,2004,1882,1864,1906,1927,1908,1823,1904,1951,1868,1881,1890,1916,1907,1814,1905,1904,1905,1869,1868,1978,1897,1854,1897,1913,1917,1862,1892,1965,1872,1891,1899,1918,1906,1822,1902,1913,1897,1872,1866,1957,1905,1820,1907,1917,1904,1845,1893,1986,1868,1882,1906,1918,1908,1836,1904,1938,1889,1891,1868,1948,1908,1804,1912,1907,1903,1847,1881,1986,1871,1863,1916,1901,1910,1827,1907,1977,1865,1899,1880,1956,1917,1790,1914,1905,1905,1888,1855,1981,1880,1844,1925,1851,1921,1826,1882,2000,1853,1948,1874,1912,1961,1736,1930,1915,1870,1994,1793,2076,1901,1742,2040,1587,1997,1828,1526,3214,1948,258,2276,2374,1672,2221,1767,1920,1963,1639,1982,1884,1875,1958,1835,2048,1862,1820,1949,1829,1923,1813,1889,2011,1850,1889,1885,1913,1934,1781,1917,1954,1876,1907,1876,1986,1880,1826,1933,1887,1903,1865,1875,1970,1882,1868,1889,1898,1929,1800,1896,1958,1878,1883,1885,1962,1892,1825,1927,1917,1892,1887,1881,1970,1886,1862,1896,1900,1922,1816,1882,1953,1891,1876,1877,1921,1912,1827,1914,1919,1883,1893,1882,1969,1892,1863,1901,1911,1920,1845,1881,1973,1882,1856,1894,1922,1901,1798,1921,1924,1877,1883,1888,1962,1888,1833,1919,1930,1905,1859,1876,1998,1886,1868,1897,1924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
,1073,3538,3849,1595,2,1585,4022,1287,416,3687,2680,78,2593,3699};

/*
	Generate a signal with 0,1 and benchmark demodulation of frames.
*/
void fsk_demod_test_1()
{
	// Simulate undersampled data
	int sr = 1198080;
	int fc = 299520;
	int br=115200;
	int f0 = fc-br/2;
	int f1 = fc+br/2;

	//unsigned short data[CICBUFSIZ*4];
	signed short data[CICBUFSIZ];
	unsigned datalen=sizeof(data)/sizeof(unsigned short);

	fprintf(file_pri,"Test data lenghth: %d\n",datalen);
	fprintf(file_pri,"Float: %f\n",3.141592);

	fsk_gentestsignal(data,datalen,sr,f0,f1,br);

	fprintf(file_pri,"Data: "); print_array_short(file_pri,data,datalen);

	fsk_demod_bench(data,datalen);
}
/*
	Generate a signal with well known artificial spectrum, and print I, Q and CP after each frame.
*/
void fsk_demod_test_2()
{
	// Generate well recognised spectrum.
	// Simulate undersampled data
	//int sr = 1198080;
	//int fc = 299520;
	//int br=115200;
	//int f0 = fc-br/2;
	//int f1 = fc+br/2;


	signed short data[FSKTESTSIGNALLEN];			// Same length as matlab
	unsigned datalen=sizeof(data)/sizeof(unsigned short);


	fprintf(file_pri,"Test data lenghth: %d\n",datalen);
	fprintf(file_pri,"Float: %f\n",3.141592);
	// Clear target
	for(int i=0;i<datalen;i++)
		data[i] = 0;

	//fsk_gentestsignal2(data,datalen,sr,fc,bfs,bff);
	fsk_gentestsignal2b(data);

	fprintf(file_pri,"Data: "); print_array_short(file_pri,data,datalen);

	// Step-by-step demodulation.
	// Number of frames
	int nf = FSKTESTSIGNALLEN/CICBUFSIZ;

	unsigned log=0;
	FILE *file = ufat_log_open(log);
	if(!file)
	{
		fprintf(file_pri,"Error opening log %d\n",log);
		return;
	}

	fsk_demod_init();
	for(int fi=0;fi<nf;fi++)
	//for(int fi=0;fi<1;fi++)
	{
		fprintf(file_pri,"Processing frame %d out of %d\n",fi,nf);
		fprintf(file_pri,"Data: "); print_array_short(file_pri,&data[fi*CICBUFSIZ],CICBUFSIZ);
		// Initialise the internal buffers for easy debugging
		for(unsigned i=0;i<CICBUFSIZ/2;i++)
		{
			_fsk_di[i+1]=_fsk_dq[i+1]=0xfffff;		// +1 as di,dq has +1 size
			_fsk_cp[i]=0xfffff;
		}
		//CICBUFSIZ

		fsk_demod_frame(&data[fi*CICBUFSIZ],_fsk_binary,1);

		fprintf(file_pri,"I:\n"); for(unsigned i=0;i<CICBUFSIZ/2;i++) fprintf(file_pri,"%d ",_fsk_di[i+1]>>8); fprintf(file_pri,"\n");
		fprintf(file_pri,"Q:\n"); for(unsigned i=0;i<CICBUFSIZ/2;i++) fprintf(file_pri,"%d ",_fsk_dq[i+1]>>8); fprintf(file_pri,"\n");
		//fprintf(file_pri,"CP:\n"); for(unsigned i=0;i<CICBUFSIZ/2;i++) fprintf(file_pri,"%d ",_fsk_cp[i]); fprintf(file_pri,"\n");
		fprintf(file_pri,"CPsign:\n"); for(unsigned i=0;i<CICBUFSIZ/2;i++) fprintf(file_pri,"%d ",_fsk_binary[i]); fprintf(file_pri,"\n");

		fprintf(file,"I:\n"); for(unsigned i=0;i<CICBUFSIZ/2;i++) fprintf(file,"%d ",_fsk_di[i+1]>>8); fprintf(file,"\n");
		fprintf(file,"Q:\n"); for(unsigned i=0;i<CICBUFSIZ/2;i++) fprintf(file,"%d ",_fsk_dq[i+1]>>8); fprintf(file,"\n");
		//fprintf(file,"CP:\n"); for(unsigned i=0;i<CICBUFSIZ/2;i++) fprintf(file,"%d ",_fsk_cp[i]); fprintf(file,"\n");
		fprintf(file,"CPsign:\n"); for(unsigned i=0;i<CICBUFSIZ/2;i++) fprintf(file,"%d ",_fsk_binary[i]); fprintf(file,"\n");


	}
	ufat_log_close();

}


/*
	Generate a signal with 1,0, and print I, Q and CP after each frame.
*/
void fsk_demod_test_3()
{
	// Simulate undersampled data
	int sr = 1198080;
	int fc = 299520;
	int br=115200;
	int f0 = fc-br/2;
	int f1 = fc+br/2;

	signed short data[CICBUFSIZ*3];
	//unsigned short data[CICBUFSIZ];
	unsigned datalen=sizeof(data)/sizeof(unsigned short);

	fprintf(file_pri,"Test data lenghth: %d\n",datalen);
	fprintf(file_pri,"Float: %f\n",3.141592);

	fsk_gentestsignal(data,datalen,sr,f0,f1,br);

	fprintf(file_pri,"Data: "); print_array_short(file_pri,data,datalen);


	// Step-by-step demodulation.
	// Number of frames
	int nf = FSKTESTSIGNALLEN/CICBUFSIZ;

	/*unsigned log=0;
	FILE *file = ufat_log_open(log);
	if(!file)
	{
		fprintf(file_pri,"Error opening log %d\n",log);
		return 1;
	}*/

	fsk_demod_init();
	for(int fi=0;fi<nf;fi++)
	//for(int fi=0;fi<1;fi++)
	{
		fprintf(file_pri,"Processing frame %d out of %d\n",fi,nf);
		fprintf(file_pri,"Data: "); print_array_short(file_pri,&data[fi*CICBUFSIZ],CICBUFSIZ);
		// Initialise the internal buffers for easy debugging
		for(unsigned i=0;i<CICBUFSIZ/2;i++)
		{
			_fsk_di[i+1]=_fsk_dq[i+1]=0xfffff;		// +1 as di,dq has +1 size
			_fsk_cp[i]=0xfffff;
		}
		//CICBUFSIZ

		fsk_demod_frame(&data[fi*CICBUFSIZ],_fsk_binary,1);

		fprintf(file_pri,"I:\n"); for(unsigned i=0;i<CICBUFSIZ/2;i++) fprintf(file_pri,"%d ",_fsk_di[i+1]>>8); fprintf(file_pri,"\n");
		fprintf(file_pri,"Q:\n"); for(unsigned i=0;i<CICBUFSIZ/2;i++) fprintf(file_pri,"%d ",_fsk_dq[i+1]>>8); fprintf(file_pri,"\n");
		//fprintf(file_pri,"CP:\n"); for(unsigned i=0;i<CICBUFSIZ/2;i++) fprintf(file_pri,"%d ",_fsk_cp[i]); fprintf(file_pri,"\n");
		fprintf(file_pri,"CPsign:\n"); for(unsigned i=0;i<CICBUFSIZ/2;i++) fprintf(file_pri,"%d ",_fsk_binary[i]); fprintf(file_pri,"\n");

		/*fprintf(file,"I:\n"); for(unsigned i=0;i<CICBUFSIZ/2;i++) fprintf(file,"%d ",_fsk_di[i+1]>>8); fprintf(file,"\n");
		fprintf(file,"Q:\n"); for(unsigned i=0;i<CICBUFSIZ/2;i++) fprintf(file,"%d ",_fsk_dq[i+1]>>8); fprintf(file,"\n");
		fprintf(file,"CP:\n"); for(unsigned i=0;i<CICBUFSIZ/2;i++) fprintf(file,"%d ",_fsk_cp[i]); fprintf(file,"\n");*/


	}
	//ufat_log_close();

}
/*
 Real data demodulation
*/
void fsk_demod_test_4()		// Real undersampled recording
{

	//int sr = 1198080;
	//int fc = 299520;
	//int br=115200;
	//int f0 = fc-br/2;
	//int f1 = fc+br/2;


	signed short data[FSKTESTSIGNALLEN];			// Same length as matlab
	unsigned datalen=sizeof(data)/sizeof(unsigned short);


	fprintf(file_pri,"Test data lenghth: %d\n",datalen);
	fprintf(file_pri,"Float: %f\n",3.141592);
	// Clear target
	for(int i=0;i<datalen;i++)
		data[i] = 0;


	fsk_gentestsignal3(data);

	fprintf(file_pri,"Data: "); print_array_short(file_pri,data,datalen);

	// Step-by-step demodulation.
	// Number of frames
	int nf = FSKTESTSIGNALLEN/CICBUFSIZ;

	/*unsigned log=0;
	FILE *file = ufat_log_open(log);
	if(!file)
	{
		fprintf(file_pri,"Error opening log %d\n",log);
		return 1;
	}*/

	fsk_demod_init();
	for(int fi=0;fi<nf;fi++)
	//for(int fi=0;fi<1;fi++)
	{
		fprintf(file_pri,"Processing frame %d out of %d\n",fi,nf);
		fprintf(file_pri,"Data: "); print_array_short(file_pri,&data[fi*CICBUFSIZ],CICBUFSIZ);
		// Initialise the internal buffers for easy debugging
		for(unsigned i=0;i<CICBUFSIZ/2;i++)
		{
			_fsk_di[i+1]=_fsk_dq[i+1]=0xfffff;		// +1 as di,dq has +1 size
			_fsk_cp[i]=0xfffff;
		}
		//CICBUFSIZ

		fsk_demod_frame(&data[fi*CICBUFSIZ],_fsk_binary,1);

		fprintf(file_pri,"I:\n"); for(unsigned i=0;i<CICBUFSIZ/2;i++) fprintf(file_pri,"%d ",_fsk_di[i+1]>>8); fprintf(file_pri,"\n");
		fprintf(file_pri,"Q:\n"); for(unsigned i=0;i<CICBUFSIZ/2;i++) fprintf(file_pri,"%d ",_fsk_dq[i+1]>>8); fprintf(file_pri,"\n");
		//fprintf(file_pri,"CP:\n"); for(unsigned i=0;i<CICBUFSIZ/2;i++) fprintf(file_pri,"%d ",_fsk_cp[i]); fprintf(file_pri,"\n");
		fprintf(file_pri,"CPsign:\n"); for(unsigned i=0;i<CICBUFSIZ/2;i++) fprintf(file_pri,"%d ",_fsk_binary[i]); fprintf(file_pri,"\n");

		/*fprintf(file,"I:\n"); for(unsigned i=0;i<CICBUFSIZ/2;i++) fprintf(file,"%d ",_fsk_di[i+1]>>8); fprintf(file,"\n");
		fprintf(file,"Q:\n"); for(unsigned i=0;i<CICBUFSIZ/2;i++) fprintf(file,"%d ",_fsk_dq[i+1]>>8); fprintf(file,"\n");
		fprintf(file,"CP:\n"); for(unsigned i=0;i<CICBUFSIZ/2;i++) fprintf(file,"%d ",_fsk_cp[i]); fprintf(file,"\n");*/


	}
	//ufat_log_close();


}


signed short tmpdata[CICBUFSIZ];
/*
	ADC data is 12-bit unsigned, i.e. 13-bit signed.
	Mean removal may not change to 12-bit depending on data distribution, hence input to CIC is 13-bit
	CIC bit growth in worst case is order-1 bits, i.e. 4 bits for 5th order. This is due to 1st stage alternating 0,
	hence the 1st stage imposes no bit growth.

	Alternative 1.
	1. ADC: 13-bit signed
	2. Mean subtract: 13-bit signed
	3. CIC: 17-bit signed


	adc: 13bit -4096-+4095
	adcms: 13 bit -4096-+4095
	cic5: 17 bit -65536-+65535
	cp: -65536*-65536=2^32->error		input must be 16-bit max

	cic5
	sr1: 16 bit -32768-+32767
	cp: -(-32768*-32768)=-1m -> -32768*-32768=1m,2^30 -> 31bit, but can't represent max positive (unlikely so no problem). 32 ok

Alternative 1: CIC5 result on on 32-bit, shift right by 1 (+8 to remove info bits) and feed to CP.

Alternative 2: shift left by 7, CIC5 result on 16-bit, do 16-bit DMA tranfer !!!!! CAN'T WORK, as input of CIC is 16-bit. Max shift left is 4.
	adcms: 13 bit -4096-+4095
	acdms_sl7: 20 bit -524288 -> + 524287
	cic5: 24 bit: -8m -> +8m
	cic5_16msb: 16 upper bits of 24-bit -32768 -> +32767
	cp: -(-32768*-32768)=-1m -> -32768*-32768=1m,2^30 -> 31bit, but can't represent max positive (unlikely so no problem). 32 ok


	cp: 2^n input (n+1 bit)->2^(2n) output

	sr16
	cic bit integration

*/
void fsk_demod_init()
{
	// Call once

	//dsp_real_to_iq_4x_cic_init_dma(_fsk_downsampling,5,0);
	//dsp_real_to_iq_4x_cic_init_dma(_fsk_downsampling,5);		// Used version
	//dsp_real_to_iq_4x_cic_init_dma(_fsk_downsampling,1);

	dsp_real_to_iq_4x_cic_init_cpu(_fsk_downsampling,5);
}
/******************************************************************************
function: fsk_demod_frame
*******************************************************************************

Demodulates a frame of 16-bit input data.

Parameters:
	data		-	Array of 16-bit samples
	binaryout	-	Array of binary demodulated output
	debug		-	Whether to print debug info (1, or 2 for verbose).

Returns:
	-

Benchmarks

	32-bit CIC with blocking CPU read
		dsp_crossproductsign_stream_sr			2005/s
	16-bit CIC with blocking CPU read
		dsp_crossproductsign_stream_in16		1971/s
		dsp_crossproductsign_stream_in16_simd	2088/s
		dsp_crossproductsign_stream_in16_simd_2	2154/s
		dsp_crossproductsign_stream_in16_simd_3	2156/s

	32-bit CIC with nop CPU read
		dsp_crossproductsign_stream_sr			2552/s
	16-bit CIC with nop CPU read
		dsp_crossproductsign_stream_in16		2642/s
		dsp_crossproductsign_stream_in16_simd	2856/s
		dsp_crossproductsign_stream_in16_simd_2	2980/s
		dsp_crossproductsign_stream_in16_simd_3	2984/s


******************************************************************************/
unsigned fsk_demod_frame(signed short * restrict data,unsigned char *restrict binaryout,unsigned debug)
{
	unsigned t1,t2,t3,t4,t5;
	unsigned tt1,tt2,tt3;
	// Call after every new data frame
	// Data frame is assumed to be CICBUFSIZ in length

	// === Calculate mean ===
	if(debug) t1 = timer_us_get();
	signed mean = dsp_mean_simd_12u_16u(data,CICBUFSIZ);
	if(debug) t2 = timer_us_get();


	// Print
	//print_array_short(data,CICBUFSIZ);

	// === Convert to IQ with CIC low-pass filtering and downsampling ===
	//dsp_real_to_iq_4x_cic_process_dma(data,_fsk_di+1,_fsk_dq+1,CICBUFSIZ,mean);		// +1 to keep IQ sample of previous frame.

#if DSP_FSK_USE_CIC_16BIT==1
	dsp_real_to_iq_4x_cic_process_cpu_msb(data,_fsk_dis+1,_fsk_dqs+1,CICBUFSIZ,mean);		// 16-bit result instead of 32.
#else
	dsp_real_to_iq_4x_cic_process_cpu(data,_fsk_di+1,_fsk_dq+1,CICBUFSIZ,mean);		// +1 to keep IQ sample of previous frame.
#endif

	if(debug) t3 = timer_us_get();

	/*if(debug)
	{
		tt1 = timer_us_get();
		dsp_real_to_iq_4x_split(data,_fsk_tmp_di,_fsk_tmp_dq,CICBUFSIZ,mean);		// Trial to split adc into IQ lane to postpone CIC filtering by feeding with DMA
		tt2 = timer_us_get();

	}*/



	// === Direction of rotation through cross-product ===
	if(debug==2) tt1 = timer_us_get();
#if DSP_FSK_USE_CIC_16BIT==1
	//dsp_crossproductsign_stream_in16(_fsk_dis,_fsk_dqs,binaryout,CICBUFSIZ/2,12);
	//dsp_crossproductsign_stream_in16_simd(_fsk_dis,_fsk_dqs,binaryout,CICBUFSIZ/2,12);
	//dsp_crossproductsign_stream_in16_simd_2(_fsk_dis,_fsk_dqs,binaryout,CICBUFSIZ/2,12);
	dsp_crossproductsign_stream_in16_simd_3(_fsk_dis,_fsk_dqs,binaryout,CICBUFSIZ/2,12);
#else
	//dsp_crossproduct_stream_sr(_fsk_di,_fsk_dq,_fsk_cp,CICBUFSIZ/2,12);
	dsp_crossproductsign_stream_sr(_fsk_di,_fsk_dq,binaryout,CICBUFSIZ/2,12);			// Calculate sign of crossproduct and store directly in bit vector
#endif

	//dsp_crossproduct_stream_h16(_fsk_di,_fsk_dq,_fsk_cp2,CICBUFSIZ/2);
	//dsp_crossproduct_stream_h16_simd(_fsk_di,_fsk_dq,_fsk_cp3,CICBUFSIZ/2);
	if(debug==2) tt2 = timer_us_get();
	if(debug==2) fprintf(file_pri,"cp: %u us\n",tt2-tt1);
#if 0
	{
		tt1 = timer_us_get();
		//dsp_crossproduct_stream_sr2(_fsk_di,_fsk_dq,_fsk_cp2,CICBUFSIZ/2,12);
		//dsp_crossproduct_stream_h16_simd(_fsk_di,_fsk_dq,_fsk_cp3,CICBUFSIZ/2);
		for(unsigned i=0;i<100;i++)
		dsp_crossproductsign_stream_in16_simd_3(_fsk_dis,_fsk_dqs,_fsk_binary2,CICBUFSIZ/2,12);
		//dsp_crossproduct_stream_h16(_fsk_di,_fsk_dq,_fsk_cp2,CICBUFSIZ/2);
		//dsp_crossproduct_stream_h16_2(_fsk_di,_fsk_dq,_fsk_cp2,CICBUFSIZ/2);
		tt2 = timer_us_get();
		for(unsigned i=0;i<100;i++)
		dsp_crossproductsign_stream_in16_simd_2(_fsk_dis,_fsk_dqs,_fsk_binary3,CICBUFSIZ/2,12);
		//dsp_crossproduct_stream_sr2(_fsk_di,_fsk_dq,_fsk_cp2,CICBUFSIZ/2,12);
		//dsp_crossproduct_stream_h16(_fsk_di,_fsk_dq,_fsk_cp3,CICBUFSIZ/2);
		//dsp_crossproduct_stream_h16(_fsk_di,_fsk_dq,_fsk_cp2,CICBUFSIZ/2);
		tt3 = timer_us_get();
		for(unsigned s=0;s<4;s++)
		{
			for(unsigned i=s*128;i<s*128+128;i++)
				fprintf(file_pri,"%d",binaryout[i]);
			fprintf(file_pri,"\n");
			for(unsigned i=s*128;i<s*128+128;i++)
				fprintf(file_pri,"%d",_fsk_binary2[i]);
			fprintf(file_pri,"\n");
			for(unsigned i=s*128;i<s*128+128;i++)
				fprintf(file_pri,"%d",_fsk_binary3[i]);
			fprintf(file_pri,"\n");
			fprintf(file_pri,"\n");
		}

		// compare
		unsigned eq=1;
		for(unsigned i=0;i<CICBUFSIZ/2;i++)
		{
			//if(_fsk_cp[i]!=_fsk_cp2[i])
			//if(_fsk_cp2[i]!=_fsk_cp3[i])
			if( (binaryout[i]!=_fsk_binary2[i]) || (_fsk_binary2[i]!=_fsk_binary3[i]) )
			{
				//fprintf(file_pri,"Mismatch at %d: %d %d %d\n",i,binaryout[i],_fsk_binary2[i],_fsk_binary3[i]);
				eq=0;
				break;
			}
		}
		fprintf(file_pri,"cp, cp2 equal: %d\n",eq);
		if(debug==2)
		{
			fprintf(file_pri,"cp2: %u us\n",tt2-tt1);
			fprintf(file_pri,"cp3: %u us\n",tt3-tt2);
		}
	}
#endif

	if(debug) t4 = timer_us_get();

	// === Prepare for next frame streaming processing ===
	// The last I and Q sample is copied at the "past" IQ location to ensure streaming of crossproduct
#if DSP_FSK_USE_CIC_16BIT==1
	_fsk_dis[0] = _fsk_dis[CICBUFSIZ/2];		// Last sample of "current" frame copied to last sample of "previous" frame
	_fsk_dqs[0] = _fsk_dqs[CICBUFSIZ/2];		// Last sample of "current" frame copied to last sample of "previous" frame
#else
	_fsk_di[0] = _fsk_di[CICBUFSIZ/2];		// Last sample of "current" frame copied to last sample of "previous" frame
	_fsk_dq[0] = _fsk_dq[CICBUFSIZ/2];		// Last sample of "current" frame copied to last sample of "previous" frame
#endif


	if(debug) t5 = timer_us_get();


	unsigned t=0;
	if(debug)
	{
		t += t2-t1;
		t += t3-t2;
		t += t4-t3;
		t += t5-t4;

		if(debug==2) fprintf(file_pri,"Mean: %d\n",mean);
		if(debug==2) fprintf(file_pri,"%u %u %u %u\n",t2-t1,t3-t2,t4-t3,t5-t4);
		//if(debug==2) fprintf(file_pri,"split %u\n",tt2-tt1);
	}
	return t;
}


void fsk_demod_bench(signed short * restrict data,int len)
{
	unsigned t1,t2;
	if(len!=CICBUFSIZ)
	{
		fprintf(file_pri,"Invalid length\n");
		return;
	}



	fsk_demod_init();

	unsigned t_last=timer_s_wait(),t_cur;
	unsigned tint1=timer_ms_get_intclk();
	unsigned nsample=0;
	unsigned mintime=1;
	while((t_cur=timer_s_get())-t_last<mintime)
	{
		fsk_demod_frame(data,_fsk_binary,0);
		nsample++;
		//break;	// do once only
	}
	unsigned tint2=timer_ms_get_intclk();
	fprintf(file_pri,"Time: %ds (%lu intclk ms) Frames: %lu. Frames/sec: %lu\n",t_cur-t_last,tint2-tint1,nsample,nsample/(t_cur-t_last));



}
/*
 Generate a test signal alternating f0, f1 at br intervals.
 Phase continuous
*/
void fsk_gentestsignal(signed short *target,int len,int sr,int f0,int f1,int br)
{
	float dt = 1.0/sr;
	float pi = 3.14159265358979323846;
	float bt = 1.0/br; 	// Bit duration
	// y = cos( w * dt * i ) with dt time in-between samples, i index of sample. I.e. phase increment is equal to w*dt

	float w[2] = {2*pi*f0, 2*pi*f1};		// Possible phase increments
	float ph=0;	// Current phase
	for(unsigned i=0;i<len;i++)
	{
		target[i] = (short)(cos(ph)*1023.0+1024.0);

		int b = (dt*i)/bt;	// Current bit
		b=b%2;				// Bit 0 or 1
		ph+=w[b]*dt;		// Increment phase according to
	}



}


/*
 Generate a test signal with a well defined shape.
 Generate rising amplitude from fc-bfs/2 to fc+bfs/2
 Generate rising but lower amplitude from fc+bfs/2 to fc+bff/2; and from -fc-bff/2 to -fc-bfs/2
*/
void fsk_gentestsignal2(signed short *target,int len,int sr,int fc,float bfs, float bff)
{
	float dt = 1.0/sr;
	float pi = 3.14159265358979323846;
	// y = cos( w * dt * i ) with dt time in-between samples, i index of sample. I.e. phase increment is equal to w*dt

	float ampmul = 16.0;		// Ensure a "unit" cosine is has ampmul peak amplitude.

	int nl = 50;		// Number of cosines to generate.
	// Add signal to bandpass
	// Left half
	float fi=0;
	fprintf(file_pri,"Adding to bandpass: lower\n");
	for(float f = fc-bfs/2; f<fc; f+=bfs/nl)
	//float f = fc;
	{
		float amp = 1.5+3.0*fi;
		dsp_addcoswave(target,len,sr,f,amp*ampmul,0);
		//tmp_s=tmp_s*(1.5+3*fi);
		fi=fi+1.0/nl;
	}
	// Right half
	fprintf(file_pri,"Adding to bandpass: upper\n");
	for(float f=fc; f<fc+bfs/2; f+=bfs/nl)
	{
		float amp = 1.5+3.0*fi;
		dsp_addcoswave(target,len,sr,f,amp*ampmul,0);
		//tmp_s=tmp_s*(1.5+3*fi);
		fi=fi+1/nl;
	}
	// Add to filter bandpass
	// Upper
	nl=50;
	fi=0;
	float sc=1.25;
	//fr1=[fc+bfs/2:(bff-bfs)/2/nl:fc+bff/2];
	//fr2=[fc+bff/2:-(bff-bfs)/2/nl:fc+bfs/2];
	fprintf(file_pri,"Adding to noise bandpass: upper\n");
	for(float f = fc+bfs/2; f<fc+bff/2; f+=(bff-bfs)/2.0/nl)
	{
		float amp = 1.0/sc/nl*fi;
		dsp_addcoswave(target,len,sr,f,amp*ampmul,0);
		//tmp_s = tmp_s./sc./nl.*fi;
		fi=fi+1;
	}
	// Lower
	fi=0;
	//fr1 = [fc-bfs/2:-(bff-bfs)/2/nl:fc-bff/2];
	//fr2 = [fc-bff/2:(bff-bfs)/2/nl:fc-bfs/2];
	fprintf(file_pri,"Adding to noise bandpass: lower\n");
	for(float f = fc-bfs/2; f>fc-bff/2; f+= -(bff-bfs)/2.0/nl)
	{
		float amp = 1.0/sc/nl*fi;
		dsp_addcoswave(target,len,sr,f,amp*ampmul,0);
		//tmp_s = tmp_s./sc./nl.*fi;
		fi=fi+1;
	}
}
// Hard-coded test signal of fsk_gentestsignal2
void fsk_gentestsignal2b(signed short *target)
{
	for(int i=0;i<FSKTESTSIGNALLEN;i++)
		target[i] = testsignal_recognizablespectrum[i];
}
void fsk_gentestsignal3(signed short *target)
{
	for(int i=0;i<FSKTESTSIGNALLEN;i++)
		target[i] = testsignal_realundersampled_0[i];
}





/******************************************************************************
	function: fsk_demodout_to_decodein
*******************************************************************************
	Convert the crossproduct output to a binary stream for decoding.

******************************************************************************/
#if 0
void fsk_demodout_to_decodein()
{
	for(unsigned i=0;i<CICBUFSIZ/2;i++)
	{
		_fsk_binary[i] = (_fsk_cp[i]>0)?1:0;
	}
}
#endif
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
