droggen/BlueSense4/firmware/v4/firmware-main/usrsrc/megalol/stmadcfast.c

#if 1
/*
 * stmadc.c
 *
 *  Created on: 12 janv. 2020
 *      Author: droggen
 */
#include <string.h>
#include <stdio.h>
#include "adc.h"
#include "atomicop.h"
#include "usrmain.h"
#include "global.h"
#include "stmadcfast.h"
#include "stmadc.h"
#include "stmadcfast.h"
#include "stmrcc.h"
#include "wait.h"
#include "stm32l4xx_ll_tim.h"
#include "serial_itm.h"

unsigned short _stm_adcfast_dmabuf[ADCFAST_BUFFERSIZE*2];										// DMA tempory buffer - DMA uses double buffering so buffer twice the size of the payload (maxchannel)
unsigned short *_stm_adcfast_dmabuf_halfptr;														// Pointer to the second half of the DMA buffer

unsigned short _stm_adcfast_buffers[STM_ADCFAST_BUFFER_NUM][ADCFAST_BUFFERSIZE];		// ADC buffer: in DMA/interrupts; emptied by user application. Buffer size: ADCFAST_BUFFERSIZE entries
unsigned long _stm_adcfast_buffers_time[STM_ADCFAST_BUFFER_NUM];							// ADC buffer acquisition time
unsigned long _stm_adcfast_buffers_pktnum[STM_ADCFAST_BUFFER_NUM];							// ADC buffer packet counter

unsigned _stm_adcfast_effframesize;														// ADC acquires data in interleaved fashion and the effective frame size is an integer multiple of the channels acquired
unsigned long _stm_adcfast_ctr_acq,_stm_adcfast_ctr_loss;


unsigned short _stm_adcfast_buffer_rdptr,_stm_adcfast_buffer_wrptr;					// Read and write pointers

/******************************************************************************
	file: stmadc.c
*******************************************************************************


	*Hardware characteristics*

	* ADC: ADC1 on APB2
	* Timer to trigger ADC: TIM15 on APB2


	*Development information*
	Data is buffered in frames. Data within frames is interleaved. This ordering respects the natural way in which the DMA transfers data into memory.
	When acquiring only a single channel then the frame contains data of that channel only.
	Otherwise the frame contains c0|c1|c2...|c0|c1|c2...|c0...

	Frames can be purposefully made smaller to increase real-time responsiveness. In this implementation the remaining frame data is unused.
	This could be optimised to increase the number of frame count (i.e. have flexible frame number and frame size with framenumber*framesize=framemem.

	Data is stored as follows:
		data[frame][interleavedsamples]


	Two buffering behaviors are offered depending on STMADCFAST_KEEPOLDEST.
	With STMADCFAST_KEEPOLDEST=1, the buffering behavior is to keep old frames if the buffer is full. Buffered frames can become old, depending on readout speed.
	With STMADCFAST_KEEPOLDEST=0, the oldest frame is evicted when a new frame is received. This guarantees that buffered frames are the most recent.


	* Main functions*
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
