droggen/BlueSense4/(commit log)

2020-03-03 Initial import of BlueSense4 firmware. Working: MPU, ADC, DAC, BT, USB. User interface compatible with BlueSense2.
    [bs4v3-blinky Run (2).cfg, bs4v3-blinky Run (3).cfg]
2020-03-03 Hardware v3 schematic, layout and BOM.
    [bluesense4_v3.xls]
2020-03-04 Fix compilation issues. Main repository from now on.
    [bs4v3-blinky Run (3).cfg, firmware-main Run.cfg]
2020-03-09 Firmware: Multimodal working.
    [firmware-main Run.cfg]
2020-03-12 peripheral power control command.
2020-04-03 - Mode for ramp signal generation - New ADC fast sampling on 12 bits.
2020-06-18 - Add/fix measurement of power during off periods. - Add 'o' command to get power during off.
    [bs4-init.c, commandset.c, commandset.h, eeprom-m24.c, eeprom-m24.h, global.h, m24xx.c, m24xx.h]
2020-06-27 - fix status reporting at end of multimodal recordings - multimodal mode is set to 8KHz audio and 225Hz motion.
    [commandset.c, mode_sample_adc.c, mode_sample_multimodal.c, mode_sample_sound.c, serial_uart.c]
2020-07-27 Firmware v4 initial import
    [firmware-v4 Run (1).cfg, firmware-v4 Run.cfg]
2020-08-03 Audio: improved quality in 8, 16 and 20KHz mode by increasing microphone frequency and using higher order filters.
2020-08-23 Updated to cubemx 6.0.1 and FW HAL/LL 1.16 Added power measurement functions
2020-08-31 - Added support for MAX31343 RTC - Use MAX31343 as the default RTC - Bugfix in USB CDC (related to line encoding) preventing some apps to open the VCP - Added power off / alarm wake up with the exter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
    [bs4-init.c, command_datetime.c, commandset.c, commandset.h, dsystick.c, global.c]
2020-09-01 Added UART reception with DMA
2020-09-04 Fix benchmark using second counter USB bug should be fixed
    [bs4-init.c, circbuf.c, circbuf.h, global.c, global.h, mode_benchmarks.c, mode_benchmarks.h]
2020-09-05 RTC fix: operate manually from vbat instead of auto Power off: manually shut down power before HRST (was meant to be a fix for RTC but did not work)
    [max31343.c, mode_rtcext.c, mode_rtcext.h, system-extra.c]
2020-09-05 power off manually instead of hrst
2020-09-07 uart benchmark wip
2020-09-14 USB buffer tweaks to prevent loosing interrupts
    [mode_benchmarks.c, serial_uart.c, serial_usb.c, serial_usb.h]
2020-09-14 Fix DFSDM parameters for 16MHz bus
    [stmdfsdm.c]
2020-09-14 Fixed SDIO clock divider for 16MHz bus
    [bs4-init.c, stmspi.c]
2020-09-15 Fix the coordinate system of the magnetometer. Now orientation data is correct and identical to BlueSense2.
    [mpu.c]
2020-09-21 Fix higher speed ADC sampling (up to 10KHz with 1 channel text format; 20KHz+ in binary)
    [commandset.c, mode.c, mode_adc.c, mode_main.c, mode_sample_adc.c, mode_sample_adc.h, mode_sample_multimodal.c, serial_uart.c]
2020-09-21 Tuned ADC sample time for the maximum realistic achievable sampling+streaming frequency (<30KHz)
2020-09-22 Tweaked buffer sizes. MPU status query interrupt driven.
2020-10-11 - Fixed the DAC clock frequency since the system clock was increased to 32MHz - Added a modulation mode
    [mode.c, mode.h, mode_dac.c, mode_main.c, mode_modulation.c, mode_modulation.h, stmadc.c, stmadc.h]
2021-01-02 - Fix SD format which required to issue a V command before F if the card was freshly inserted. - Cleanup of warnings in ufat.
    [ufat.c]
2021-01-03 - Larger ADC buffer - Changed ADC buffer pointer from char to short - ADC clock resolution changed from 10uS to 5uS
    [stmadc.c, stmadc.h]
2021-01-03 Fastpath in command process (currently disabled)
2021-01-03 - Tweaks to ADC sampling, benchmark
2021-01-03 printf format fix
2021-01-03 - Missing include - information command shows previous state
    [commandset.c]
2021-01-03 - I2C clear pending interrupts in case of errors
    [stmi2c-isr-stm32l401.c]
2021-01-05 - Activate DMA template for SDMMC1 - Tweaks of the template code to hide some latencies.
2021-02-09 Change sample duration from seconds to milliseconds in mode_sample_*
2021-06-28 Fixed parsing of command line
    [command.c, commandset.c]
2021-08-27 Fix timer functions to handle wraparound: timer_us_waitperiod, timer_ms_waitperiod, etc.
    [wait.c, wait.h]
2021-08-27 Fix init code to initialise timer even if RTC isn't available
    [bs4-init.c]
2021-08-27 Helper functions to plot a scope, print arrays.
2021-08-27 new stmadcfast for higher speed (Msps range) data acquisition. stmadcfast does not deinterleave the data and acquires the data in channel-interleaved frames.
2021-08-27 - softuart: software uart decoding - megalol_dsp: some dsp functions - megalol_dsp_fsk: fsk demodulation - megalol_dsp_r2ik: real-to-iq conversion
2021-09-01 Fix the use of cookies in stdio FILE by external association structure.
    [bs4-init.c, commandset.c, megalol_comm_softuart.c, serial_uart.c, serial_usb.c, ufat.c, wait.c]
2022-03-31 Schematic of v4
    [bluesense4_v4.xls]
2022-04-11 Restored the audio acquisition: correct parameters for DFSDM running at 80MHz; fixed left audio channel initialisation. WARNING: mutually exclusive with hardware CIC for compute (e.g. FSK demodulatio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
    [firmware-main Run.cfg]
