droggen/BlueSense4/(notices)

Notices in the files:
firmware/v4/firmware-main/Core/Src/main.c:
© Copyright (c) 2020 STMicroelectronics.
All rights reserved.
This software component is licensed by ST under Ultimate Liberty license
(C) COPYRIGHT STMicroelectronics *****END OF FILE
firmware/v4/firmware-main/usrsrc/megalol/wait.c:
modify it under the terms of the GNU General Public License
